sheekhoonatef15/OpenMCS/OpenMCS_V1/OpenMCS/Verification/500 ns_OpenMCS_100MHz_300MHz_test.csv

# OpenMCS 8.0.5-linear-fit-cps; clock_hz=100000000.000000; dwell_cycles=50; displayed_passes=5250235; roi_enabled=0\nTime (ns) | Count | Bin | In signal ROI | In noise ROI | Reference count
0.000000 | 0 | 0 | 0 | 0
500.000000 | 0 | 1 | 0 | 0
1000.000000 | 5250235 | 2 | 0 | 0
1500.000000 | 0 | 3 | 0 | 0
2000.000000 | 0 | 4 | 0 | 0
2500.000000 | 0 | 5 | 0 | 0
3000.000000 | 0 | 6 | 0 | 0
3500.000000 | 0 | 7 | 0 | 0
4000.000000 | 0 | 8 | 0 | 0
4500.000000 | 0 | 9 | 0 | 0
5000.000000 | 0 | 10 | 0 | 0
5500.000000 | 0 | 11 | 0 | 0
6000.000000 | 0 | 12 | 0 | 0
6500.000000 | 0 | 13 | 0 | 0
7000.000000 | 0 | 14 | 0 | 0
7500.000000 | 0 | 15 | 0 | 0
8000.000000 | 0 | 16 | 0 | 0
8500.000000 | 0 | 17 | 0 | 0
9000.000000 | 0 | 18 | 0 | 0
9500.000000 | 0 | 19 | 0 | 0
10000.000000 | 0 | 20 | 0 | 0
10500.000000 | 0 | 21 | 0 | 0
11000.000000 | 0 | 22 | 0 | 0
11500.000000 | 0 | 23 | 0 | 0
12000.000000 | 0 | 24 | 0 | 0
12500.000000 | 0 | 25 | 0 | 0
13000.000000 | 0 | 26 | 0 | 0
13500.000000 | 0 | 27 | 0 | 0
14000.000000 | 0 | 28 | 0 | 0
14500.000000 | 0 | 29 | 0 | 0
15000.000000 | 0 | 30 | 0 | 0
15500.000000 | 0 | 31 | 0 | 0
16000.000000 | 0 | 32 | 0 | 0
16500.000000 | 0 | 33 | 0 | 0
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
