sheekhoonatef15/OpenMCS/OpenMCS_V1/OpenMCS/Verification/500 ns_OpenMCS_100MHz_300MHz_test.png

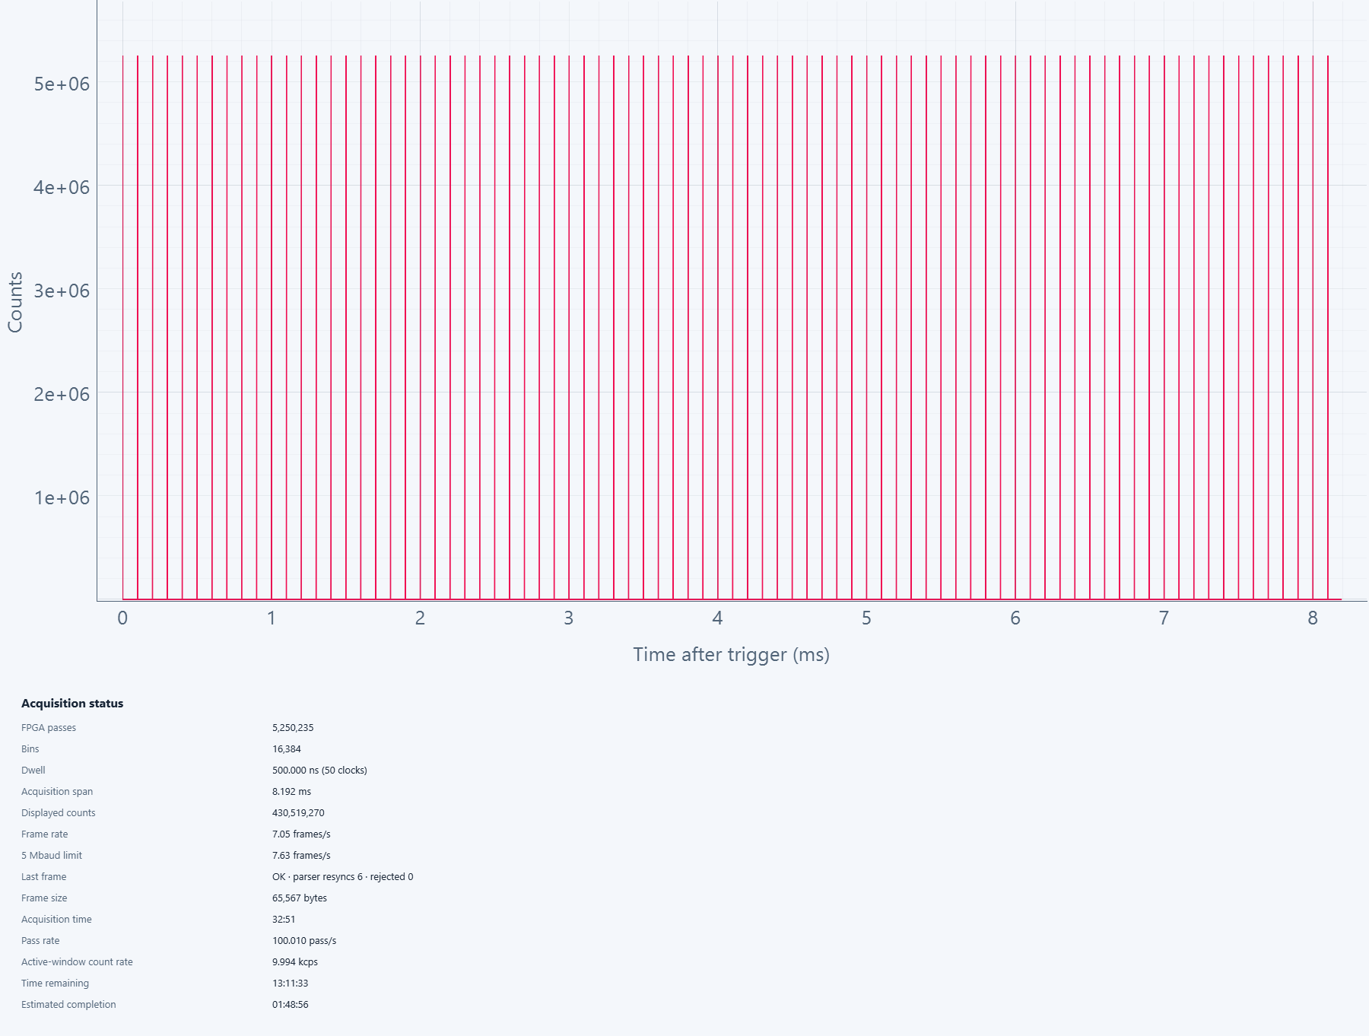
OpenMCS_V1/OpenMCS/Verification/500 ns_OpenMCS_100MHz_300MHz_test.png
