sheekhoonatef15/OpenMCS/OpenMCS_V1/OpenMCS/Software/OpenMCS_GUI.py

"""OpenMCS production GUI.

Receives FPGA-accumulated MCS6 histogram frames from the Teensy USB bridge and
performs interactive signal/background analysis.
"""

from __future__ import annotations

import math
import json
from pathlib import Path
import os
import queue
import re
import csv
from collections import deque
import struct
import sys
import threading
import time
from dataclasses import dataclass

import numpy as np
from OpenMCS_protocol import (
    FrameParser, MCS_MAGIC, LIVE_BLOCK_MAGIC, MCS_TRAILER,
    MAX_BINS, MIN_DWELL_CYCLES, EXPECTED_CLOCK_HZ,
)
import serial
import serial.tools.list_ports

os.environ["PYQTGRAPH_QT_LIB"] = "PyQt6"
import pyqtgraph as pg
import pyqtgraph.exporters

from PyQt6.QtCore import QEvent, QSettings, QSignalBlocker, QThread, QTimer, Qt, QRect, QRectF, pyqtSignal
from PyQt6.QtGui import QColor, QFont, QImage, QKeySequence, QPainter, QPen, QShortcut
from PyQt6.QtWidgets import (
    QApplication, QButtonGroup, QCheckBox, QColorDialog, QComboBox, QDoubleSpinBox,
    QFileDialog, QFormLayout, QDialog,
    QFrame, QGridLayout, QGroupBox, QHBoxLayout, QLabel, QLineEdit, QListWidget, QListWidgetItem, QMainWindow, QMessageBox,
    QPushButton, QScrollArea, QSpinBox, QSplitter, QStatusBar, QTabWidget, QTableWidget, QTableWidgetItem, QHeaderView,
    QVBoxLayout, QWidget,
)

APP_NAME = "OpenMCS"
APP_VERSION = "8.0.6-performance"
USB_BAUD = 115_200
# All released V3/V4 sketches in this project use the same line protocol.
# Match the stable family prefix so the maximum-accuracy V4 sketch connects.
TEENSY_ID = b"OPENMCS_TEENSY4_V"
STATUS_MAGIC = b"@@OPENMCS:"
DEFAULT_BINS = 10_000
MAX_MCS_DWELL_S = 0.001       # 1 ms/bin
MAX_MCS_PASS_SPAN_S = 20.0    # supports 16,384 bins at 1 ms/bin
BG = "#0b1016"
PANEL = "#121922"
PANEL_2 = "#17212c"
BORDER = "#293747"
TEXT = "#e7edf5"
MUTED = "#94a3b8"
CYAN = "#36c5f0"
GREEN = "#3ddc97"
AMBER = "#ffb454"
RED = "#ff6b6b"
LIGHT_BG = "#f4f7fb"


@dataclass(frozen=True)
class RegionMetrics:
    signal_start: int
    signal_end: int
    noise_start: int
    noise_end: int
    signal_bins: int
    noise_bins: int
    gross_signal: int
    noise_total: int
    noise_per_bin: float
    estimated_background: float
    net_signal: float
    uncertainty: float
    snr: float


def calculate_region_metrics(counts, signal_start, signal_end, noise_start, noise_end):
    """Background-scaled signal statistics for inclusive bin regions."""
    if counts.size == 0:
        raise ValueError("Histogram is empty")
    last = counts.size - 1
    signal_start = max(0, min(int(signal_start), last))
    signal_end = max(signal_start, min(int(signal_end), last))
    noise_start = max(0, min(int(noise_start), last))
    noise_end = max(noise_start, min(int(noise_end), last))
    signal_bins = signal_end - signal_start + 1
    noise_bins = noise_end - noise_start + 1
    gross = int(counts[signal_start : signal_end + 1].sum(dtype=np.uint64))
    noise_total = int(counts[noise_start : noise_end + 1].sum(dtype=np.uint64))
    noise_per_bin = noise_total / noise_bins
    scale = signal_bins / noise_bins
    background = scale * noise_total
    net = gross - background
    uncertainty = math.sqrt(max(0.0, gross + scale * scale * noise_total))
    snr = net / uncertainty if uncertainty else 0.0
    return RegionMetrics(
        signal_start, signal_end, noise_start, noise_end, signal_bins, noise_bins,
        gross, noise_total, noise_per_bin, background, net, uncertainty, snr,
    )


def linear_fit_active_rate(samples, pass_active_s):
    """Fit cumulative counts C(P)=m*P+b and return m/active-pass time."""
    if len(samples) < 2 or pass_active_s <= 0.0 or not math.isfinite(pass_active_s):
        return None
    passes = np.asarray([sample[0] for sample in samples], dtype=np.float64)
    totals = np.asarray([sample[1] for sample in samples], dtype=np.float64)
    passes -= passes.mean()
    totals -= totals.mean()
    denominator = float(np.dot(passes, passes))
    if denominator <= 0.0 or not math.isfinite(denominator):
        return None
    counts_per_pass = float(np.dot(passes, totals) / denominator)
    if counts_per_pass < 0.0 or not math.isfinite(counts_per_pass):
        return None
    return counts_per_pass / pass_active_s


def histogram_step_xy(x_values, counts):
    """Return staircase coordinates when x_values are LEFT EDGES of MCS bins.

    OpenMCS bin i spans [x[i], x[i] + dx].  For example, with a
    100 ns dwell: bin 0 = 0..100 ns, bin 1 = 100..200 ns, etc.
    """
    x = np.asarray(x_values, dtype=np.float64)
    y = np.asarray(counts)
    n = min(x.size, y.size)
    if n == 0:
        return np.asarray([], dtype=np.float64), np.asarray([], dtype=np.float64)
    x = x[:n]
    y = y[:n]

    if n == 1:
        # Safe fallback. Normal MCS displays contain multiple bins.
        dx = 1.0
    else:
        dx = float(x[-1] - x[-2])
        if not math.isfinite(dx) or dx <= 0.0:
            dx = 1.0

    # x[i] is the LEFT edge, not the center.  Append the right edge of
    # the final bin, then construct the explicit histogram staircase.
    edges = np.empty(n + 1, dtype=np.float64)
    edges[:-1] = x
    edges[-1] = x[-1] + dx
    sx = np.repeat(edges, 2)[1:-1]
    sy = np.repeat(y.astype(np.float64, copy=False), 2)
    return sx, sy




def available_ports():
    """Return serial ports with likely Teensy devices first."""
    ports = list(serial.tools.list_ports.comports())

    def is_teensy(port):
        text = " ".join(
            str(value or "")
            for value in (port.description, port.manufacturer, port.product, port.hwid)
        ).lower()
        return port.vid == 0x16C0 or "teensy" in text or "pjrc" in text

    ports.sort(key=lambda port: (not is_teensy(port), port.device))
    return ports


class SerialWorker(QThread):
    frame_received = pyqtSignal(object, object)
    connection_changed = pyqtSignal(bool, str)
    message = pyqtSignal(str, str)

    def __init__(self, port_name):
        super().__init__()
        self.port_name = port_name
        self._stop_event = threading.Event()
        self._commands = queue.Queue()
        self._status_buffer = bytearray()

    def _parse_instrument_status(self, data):
        """Display tagged Teensy messages without confusing them with MCS6 data."""
        self._status_buffer.extend(data)
        while True:
            marker = self._status_buffer.find(STATUS_MAGIC)
            if marker < 0:
                preserve = len(STATUS_MAGIC) - 1
                if len(self._status_buffer) > preserve:
                    del self._status_buffer[:-preserve]
                return
            newline = self._status_buffer.find(b"\n", marker)
            if newline < 0:
                if marker:
                    del self._status_buffer[:marker]
                return
            record = bytes(self._status_buffer[marker + len(STATUS_MAGIC):newline])
            del self._status_buffer[:newline + 1]
            try:
                level_bytes, message_bytes = record.split(b":", 1)
                level = level_bytes.decode("ascii", errors="replace").lower()
                message = message_bytes.decode("utf-8", errors="replace").strip()
            except ValueError:
                continue
            if level == "identity":
                continue
            if level not in ("info", "success", "warning", "error"):
                level = "info"
            if message:
                self.message.emit(message, level)

    @staticmethod
    def _verify_teensy(serial_port):
        """Reject a COM port unless the current OpenMCS Teensy sketch answers."""
        serial_port.reset_input_buffer()
        serial_port.write(b"i\n")
        serial_port.flush()
        reply = bytearray()
        deadline = time.monotonic() + 4.0
        while time.monotonic() < deadline:
            waiting = serial_port.in_waiting
            chunk = serial_port.read(waiting if waiting else 1)
            if chunk:
                reply.extend(chunk)
                if TEENSY_ID in reply:
                    return bytes(reply)
                if len(reply) > 8192:
                    del reply[:-4096]
        raise RuntimeError(
            "The selected COM port did not identify as the OpenMCS Teensy. "
            "Select the Teensy COM port and upload the matching OpenMCS_Teensy4_0.ino sketch."
        )

    def send_command(self, command):
        self._commands.put(command.strip() + "\n")

    def stop(self):
        self._stop_event.set()

    def run(self):
        serial_port = None
        parser = FrameParser()
        try:
            serial_port = serial.Serial(
                self.port_name, USB_BAUD, timeout=0.05, write_timeout=1.0
            )
            startup_reply = self._verify_teensy(serial_port)
            self._parse_instrument_status(startup_reply)
            self.connection_changed.emit(True, self.port_name)
            while not self._stop_event.is_set():
                while True:
                    try:
                        command = self._commands.get_nowait()
                    except queue.Empty:
                        break
                    serial_port.write(command.encode("ascii"))
                    serial_port.flush()
                waiting = serial_port.in_waiting
                data = serial_port.read(waiting if waiting else 1)
                if data:
                    self._parse_instrument_status(data)
                    for counts, metadata in parser.feed(data):
                        metadata["discarded_bytes"] = parser.discarded_bytes
                        metadata["invalid_frames"] = parser.invalid_frames
                        self.frame_received.emit(counts, metadata)
        except (serial.SerialException, OSError, RuntimeError) as error:
            self.message.emit(f"Serial connection error: {error}", "error")
        finally:
            if serial_port is not None:
                try:
                    serial_port.close()
                except serial.SerialException:
                    pass
            self.connection_changed.emit(False, self.port_name)


class MetricValue(QFrame):
    def __init__(self, title, value="—"):
        super().__init__()
        self.setObjectName("MetricValue")
        layout = QVBoxLayout(self)
        layout.setContentsMargins(10, 8, 10, 8)
        layout.setSpacing(1)
        caption = QLabel(title)
        caption.setObjectName("MetricCaption")
        self.value = QLabel(value)
        self.value.setObjectName("MetricNumber")
        self.value.setTextInteractionFlags(Qt.TextInteractionFlag.TextSelectableByMouse)
        layout.addWidget(caption)
        layout.addWidget(self.value)

    def set_value(self, value):
        self.value.setText(value)


class SelectionViewBox(pg.ViewBox):
    """ViewBox that reserves Ctrl + left-drag for histogram selection."""

    selectionDragged = pyqtSignal(float, float, bool)

    def mouseDragEvent(self, event, axis=None):
        ctrl_left_drag = (
            event.button() == Qt.MouseButton.LeftButton and
            bool(event.modifiers() & Qt.KeyboardModifier.ControlModifier)
        )
        if not ctrl_left_drag:
            super().mouseDragEvent(event, axis=axis)
            return
        event.accept()
        start = self.mapSceneToView(event.buttonDownScenePos()).x()
        current = self.mapSceneToView(event.scenePos()).x()
        self.selectionDragged.emit(
            float(min(start, current)), float(max(start, current)),
            bool(event.isFinish()),
        )


class SelectAllLineEdit(QLineEdit):
    """Select all text whenever the field is clicked."""
    def mousePressEvent(self, event):
        super().mousePressEvent(event)
        QTimer.singleShot(0, self.selectAll)


class InsetResizeHandle(QWidget):
    """Bottom-right handle that resizes only its FloatingOverview parent."""

    def __init__(self, inset):
        super().__init__(inset)
        self.inset = inset
        self._press_global = None
        self._start_size = None
        self._background = QColor("#526579")
        self._border = QColor("#94a3b8")
        self.setFixedSize(24, 24)
        self.setCursor(Qt.CursorShape.SizeFDiagCursor)
        self.setToolTip("Drag to resize overview only")
        self.setAttribute(Qt.WidgetAttribute.WA_OpaquePaintEvent, True)

    def setThemeColors(self, background, border):
        self._background = QColor(background)
        self._border = QColor(border)
        self.update()

    def paintEvent(self, event):
        painter = QPainter(self)
        painter.fillRect(self.rect(), self._background)
        painter.setPen(QPen(self._border, 2.0))
        # Three diagonal grip marks make the resize target visually obvious.
        w = self.width() - 5
        h = self.height() - 5
        for offset in (0, 6, 12):
            painter.drawLine(w - offset, h, w, h - offset)

    def mousePressEvent(self, event):
        if event.button() == Qt.MouseButton.LeftButton:
            self._press_global = event.globalPosition().toPoint()
            self._start_size = self.inset.size()
            self.grabMouse()
            event.accept()
            return
        event.ignore()

    def mouseMoveEvent(self, event):
        if self._press_global is None or self._start_size is None:
            event.ignore()
            return
        delta = event.globalPosition().toPoint() - self._press_global
        new_w = max(self.inset.minimumWidth(), self._start_size.width() + delta.x())
        new_h = max(self.inset.minimumHeight(), self._start_size.height() + delta.y())
        # Critical: resize ONLY the floating inset. No splitter, parent, or main plot changes.
        self.inset.resize(new_w, new_h)
        self.inset.raise_()
        event.accept()

    def mouseReleaseEvent(self, event):
        if self._press_global is not None:
            self._press_global = None
            self._start_size = None
            self.releaseMouse()
            event.accept()
            return
        event.ignore()


class FloatingOverview(QFrame):
    """Layout-independent overview overlay. Drag title; resize with bottom-right grip."""
    navigateRequested = pyqtSignal(float)

    def __init__(self, parent=None):
        super().__init__(parent)
        self.setObjectName("FloatingOverview")
        self.setMinimumSize(180, 120)
        self.resize(320, 190)
        self._drag_origin = None
        self._frame_origin = None

        layout = QVBoxLayout(self)
        layout.setContentsMargins(2, 2, 2, 2)
        layout.setSpacing(0)

        self.title = QLabel("Spectrum overview — drag to move")
        self.title.setFixedHeight(24)
        self.title.setCursor(Qt.CursorShape.SizeAllCursor)
        self.title.installEventFilter(self)
        layout.addWidget(self.title)

        self.plot = pg.PlotWidget()
        self.plot.setMenuEnabled(False)
        self.plot.hideAxis("left")
        self.plot.hideAxis("bottom")
        self.plot.setMouseEnabled(x=False, y=False)
        self.plot.scene().sigMouseClicked.connect(self._clicked)
        layout.addWidget(self.plot, 1)

        # Custom handle: QSizeGrip would target a top-level/subwindow and can
        # resize the OpenMCS window. This handle explicitly resizes only self.
        self.grip = InsetResizeHandle(self)
        self.grip.setThemeColors("#526579", "#cbd5e1")
        self.grip.raise_()

    def resizeEvent(self, event):
        super().resizeEvent(event)
        self.grip.move(self.width() - self.grip.width() - 2,
                       self.height() - self.grip.height() - 2)
        self.grip.raise_()

    def eventFilter(self, obj, event):
        if obj is self.title:
            if event.type() == QEvent.Type.MouseButtonPress and event.button() == Qt.MouseButton.LeftButton:
                self._drag_origin = event.globalPosition().toPoint()
                self._frame_origin = self.pos()
                return True
            if event.type() == QEvent.Type.MouseMove and self._drag_origin is not None:
                delta = event.globalPosition().toPoint() - self._drag_origin
                self.move(self._frame_origin + delta)
                self.raise_()
                return True
            if event.type() == QEvent.Type.MouseButtonRelease:
                self._drag_origin = None
                self._frame_origin = None
                return True
        return super().eventFilter(obj, event)

    def _clicked(self, event):
        if event.button() == Qt.MouseButton.LeftButton:
            point = self.plot.getViewBox().mapSceneToView(event.scenePos())
            self.navigateRequested.emit(float(point.x()))

    def addItem(self, item):
        self.plot.addItem(item)

    def setRange(self, *args, **kwargs):
        self.plot.setRange(*args, **kwargs)

    def setThemeColors(self, background, border):
        self.setStyleSheet(
            f"QFrame#FloatingOverview {{ background:{background}; border:2px solid {border}; }}"
            f"QLabel {{ background:{background}; padding-left:6px; font-weight:600; }}"
        )
        self.plot.setBackground(background)
        # Deliberately contrast the custom resize handle with the panel.
        grip_bg = "#526579" if QColor(background).lightness() < 128 else "#cbd5e1"
        grip_border = "#f8fafc" if QColor(background).lightness() < 128 else "#334155"
        self.grip.setThemeColors(grip_bg, grip_border)

class OpenMCSWindow(QMainWindow):
    def __init__(self):
        super().__init__()
        self.settings = QSettings("OpenMCS", "OpenMCS")
        self.worker = None
        self._live_preview_metadata = None
        self._live_preview_warning = False
        self.live_preview_timer = QTimer(self)
        self.live_preview_timer.setSingleShot(True)
        self.live_preview_timer.setInterval(33)
        self.live_preview_timer.timeout.connect(self._render_live_preview)
        self.latest_counts = None
        self.latest_metadata = None
        self.mcs_latest_counts = None
        self.mcs_latest_metadata = None
        self.mcs_accumulation_frames = 0
        self.counter_latest_counts = None
        self.counter_latest_metadata = None
        self.pass_number = 0
        self.accumulation_frames = 0
        self.accumulation_signature = None
        self.rejected_frames = 0
        self.frame_timestamps = deque(maxlen=512)
        self.frame_rate_ema = 0.0
        self._updating_regions = False
        self._auto_connect_attempted = False
        self.instrument_mode = "mcs"
        self.trace_color = CYAN
        self.counter_signal_color = CYAN
        self.counter_trigger_color = AMBER
        self.x_axis_mode = "time"
        self.counter_times = []
        self.counter_cps = []
        self.counter_trigger_cps = []
        self.counter_last_count = 0
        self.counter_last_trigger_count = 0
        self.counter_last_pass = 0
        self.counter_segment_count = 0
        self.counter_segment_signal_sum = 0
        self.counter_segment_trigger_sum = 0
        self.counter_segment_elapsed = 0.0
        self.counter_started = None
        self.counter_baseline_pending = True
        self.counter_segments_per_point = 1
        self.counter_accept_after = 0.0
        self.mode_accept_after = 0.0
        self.acquisition_running = False
        self.mcs_display_frozen = False
        self.mcs_view_initialized = False
        # User-requested live auto-range. Off by default so acquisition does not move the view.
        self.mcs_manual_autorange = False
        self.mcs_clear_pending = False
        self.configured_signature = None
        self.highlighted_bins = None
        # Frozen comparison/reference histogram. This is GUI-only and survives
        # new acquisitions until explicitly replaced or removed.
        self.reference_counts = None
        self.reference_metadata = None
        self.reference_curve = None
        self.reference_axis_mode = None
        self.acquisition_started_at = None
        self.acquisition_stopped_at = None
        self.acquisition_baseline_passes = 0
        self.acquisition_target_passes = None
        # MCS live-rate history. Rates are calculated from successive cumulative
        # FPGA frames, never from GUI paint/update frequency.
        self.mcs_rate_times = []  # retain full CPS history for troubleshooting
        self.mcs_count_rates = []
        self.mcs_pass_rates = []
        self.mcs_rate_last_time = None
        self.mcs_rate_last_total = None
        self.mcs_rate_last_passes = None
        self.mcs_rate_started = None
        self.mcs_rate_fit_samples = deque(maxlen=8)
        self.mcs_rate_fit_signature = None
        # First live MCS frame after every Start is baseline-only for CPS.
        self.mcs_rate_baseline_pending = True
        self.eta_pass_samples = deque()
        self.eta_window_seconds = 10.0
        self.eta_min_span_seconds = 1.0
        self.eta_last_rate = None
        self.eta_interval_values = []
        self.eta_interval_rates = []
        self.eta_display_eta = None
        self.eta_display_rate = None
        self.eta_last_display_update = time.monotonic()
        self.eta_display_period_s = 5.0
        self._counter_start_pending = False
        # Independent plot view ranges are preserved when switching modes.
        self._mcs_saved_view = None
        self._counter_saved_view = None
        # User-measured acquisition clock. The FPGA protocol continues to
        # identify the nominal 100 MHz design; this value corrects all physical
        # time and rate calculations in both MCS and Counter displays.
        self.clock_frequency_hz = self.settings.value(
            "calibration/clock_hz", float(EXPECTED_CLOCK_HZ), float
        )
        self._layout_editor = None
        self._layout_selected_widget = None
        self._layout_selected_style = ""
        self._layout_edit_active = False

        self.setWindowTitle(f"{APP_NAME} {APP_VERSION} — Multichannel Scaler")
        self.resize(1280, 780)
        self.setMinimumSize(980, 640)
        self._build_ui()
        self._connect_signals()
        self._install_shortcuts()
        self._restore_settings()
        self._set_connected(False)
        self.refresh_ports()
        self.port_timer = QTimer(self)
        self.port_timer.timeout.connect(self.refresh_ports)
        self.port_timer.start(2000)
        self.acquisition_timer = QTimer(self)
        self.acquisition_timer.timeout.connect(self._update_acquisition_timing)
        self.acquisition_timer.start(250)
        QTimer.singleShot(350, self._try_initial_auto_connect)

    def _build_ui(self):
        scroll_area = QScrollArea()
        scroll_area.setObjectName("MainScrollArea")
        scroll_area.setWidgetResizable(True)
        scroll_area.setFrameShape(QFrame.Shape.NoFrame)
        root = QWidget()
        # Preserve a useful plot height on smaller displays. The main window
        # becomes vertically scrollable instead of compressing labels, toolbars,
        # and plots until text disappears.
        root.setMinimumSize(900, 820)
        scroll_area.setWidget(root)
        self.main_scroll_area = scroll_area
        self.setCentralWidget(scroll_area)
        outer = QVBoxLayout(root)
        outer.setContentsMargins(14, 12, 14, 10)
        outer.setSpacing(10)

        header = QHBoxLayout()
        self.header_layout = header
        title_box = QVBoxLayout()
        self.app_title_label = QLabel("OpenMCS")
        self.app_title_label.setObjectName("CompactTitle" if os.environ.get("OPENQMA_EMBEDDED") else "AppTitle")
        self.app_subtitle_label = QLabel(
            "Triggered multichannel scaler · 100 MHz FPGA accumulation · "
            "GUI v6.7"
        )
        self.app_subtitle_label.setObjectName("AppSubtitle")
        self.app_subtitle_label.setWordWrap(True)
        self.app_subtitle_label.setMinimumWidth(0)
        if os.environ.get("OPENQMA_EMBEDDED"):
            self.app_subtitle_label.setVisible(False)
        title_box.addWidget(self.app_title_label)
        title_box.addWidget(self.app_subtitle_label)
        header.addLayout(title_box)
        header.addStretch(1)

        # Always-visible mode selector. Switching instruments should not
        # require opening Setup or finding a combo box among acquisition fields.
        mode_switch = QFrame()
        mode_switch.setObjectName("ModeSwitch")
        mode_layout = QHBoxLayout(mode_switch)
        mode_layout.setContentsMargins(4, 4, 4, 4)
        mode_layout.setSpacing(3)
        mode_label = QLabel("MODE")
        mode_label.setObjectName("ModeLabel")
        self.mcs_mode_button = QPushButton("MCS")
        self.counter_mode_button = QPushButton("COUNTER")
        for button in (self.mcs_mode_button, self.counter_mode_button):
            button.setObjectName("ModeButton")
            button.setCheckable(True)
            button.setMinimumWidth(86)
        self.mcs_mode_button.setToolTip("Triggered multichannel scaler (Ctrl+1)")
        self.counter_mode_button.setToolTip("Continuous CPS alignment counter (Ctrl+2)")
        self.mode_button_group = QButtonGroup(self)
        self.mode_button_group.setExclusive(True)
        self.mode_button_group.addButton(self.mcs_mode_button)
        self.mode_button_group.addButton(self.counter_mode_button)
        self.mcs_mode_button.setChecked(True)
        mode_layout.addWidget(mode_label)
        mode_layout.addWidget(self.mcs_mode_button)
        mode_layout.addWidget(self.counter_mode_button)
        header.addWidget(mode_switch)

        self.setup_button = QPushButton("Setup")
        self.setup_button.setToolTip("Show acquisition setup (Ctrl+, or F2)")
        self.shortcuts_button = QPushButton("Shortcuts")
        self.shortcuts_button.setCheckable(True)
        self.shortcuts_button.setToolTip("Show/hide keyboard shortcuts")
        self.theme_combo = QComboBox()
        self.theme_combo.addItem("Dark", "dark")
        self.theme_combo.addItem("Light", "light")
        self.theme_combo.setToolTip("Interface color theme")
        self.help_button = QPushButton("Help")
        self.help_button.setToolTip("Open help and keyboard shortcuts (F1)")
        self.layout_button = QPushButton("Edit layout")
        self.layout_button.setToolTip("Show, hide, and resize the workspace panels")
        self.header_actions = QWidget()
        self.header_actions_layout = QHBoxLayout(self.header_actions)
        self.header_actions_layout.setContentsMargins(0, 0, 0, 0)
        self.header_actions_layout.setSpacing(8)
        self.header_actions_layout.addWidget(self.setup_button)
        self.header_actions_layout.addWidget(self.layout_button)
        self.header_actions_layout.addWidget(self.shortcuts_button)
        self.header_actions_layout.addWidget(self.theme_combo)
        self.header_actions_layout.addWidget(self.help_button)
        header.addWidget(self.header_actions)
        self.connection_badge = QLabel("●  DISCONNECTED")
        self.connection_badge.setObjectName("ConnectionBadge")
        header.addWidget(self.connection_badge)
        outer.addLayout(header)

        # The right Status/ROI pane spans the full working height.  Everything
        # that supports acquisition lives in a compact left stack so the plot
        # receives essentially all remaining space.
        self.workspace_splitter = QSplitter(Qt.Orientation.Horizontal)
        self.workspace_splitter.setChildrenCollapsible(False)
        self.workspace_splitter.setHandleWidth(3)
        outer.addWidget(self.workspace_splitter, 1)

        left_workspace = QWidget()
        left_workspace_layout = QVBoxLayout(left_workspace)
        left_workspace_layout.setContentsMargins(0, 0, 0, 0)
        left_workspace_layout.setSpacing(8)
        self.workspace_splitter.addWidget(left_workspace)

        connection = QFrame()
        self.connection_bar = connection
        connection.setObjectName("ControlBar")
        connection_layout = QHBoxLayout(connection)
        self.connection_layout = connection_layout
        connection_layout.setContentsMargins(10, 5, 10, 5)
        self.instrument_label = QLabel("Instrument")
        connection_layout.addWidget(self.instrument_label)
        self.port_combo = QComboBox()
        self.port_combo.setMinimumWidth(220)
        self.refresh_button = QPushButton("Refresh")
        self.connect_button = QPushButton("Connect")
        self.connect_button.setObjectName("PrimaryButton")
        self.auto_connect_check = QCheckBox("Auto-connect")
        self.auto_connect_check.setChecked(True)
        connection_layout.addWidget(self.port_combo, 1)
        connection_layout.addWidget(self.refresh_button)
        connection_layout.addWidget(self.auto_connect_check)
        connection_layout.addWidget(self.connect_button)
        left_workspace_layout.addWidget(connection)

        # Persistent experiment save target. This removes repeated Save dialogs
        # during acquisition: choose a folder and run name once, then use Save Data.
        save_bar = QFrame()
        self.save_bar = save_bar
        save_bar.setObjectName("ControlBar")
        save_layout = QHBoxLayout(save_bar)
        self.save_layout = save_layout
        save_layout.setContentsMargins(10, 5, 10, 5)
        save_layout.setSpacing(6)

        self.save_to_label = QLabel("Save to")
        save_layout.addWidget(self.save_to_label)
        self.save_directory_edit = QLineEdit()
        self.save_directory_edit.setPlaceholderText("Experiment folder")
        self.save_directory_edit.setToolTip("Folder used by Save Data")
        self.save_directory_edit.setMinimumWidth(220)

        self.browse_save_directory_button = QPushButton("Browse…")
        self.browse_save_directory_button.setToolTip("Choose experiment folder")

        save_layout.addWidget(self.save_directory_edit, 2)
        save_layout.addWidget(self.browse_save_directory_button)

        self.run_name_label = QLabel("Run name")
        save_layout.addWidget(self.run_name_label)
        self.run_name_edit = SelectAllLineEdit()
        self.run_name_edit.setPlaceholderText("sample_001")
        self.run_name_edit.setToolTip(
            "Base filename. Save Data always creates CSV and optionally creates PNG. "
            "The entered name is preserved; an existing name receives a numbered suffix."
        )
        self.run_name_edit.setMinimumWidth(150)
        save_layout.addWidget(self.run_name_edit, 1)

        self.data_settings_button = QPushButton("Data Settings…")
        self.data_settings_button.setToolTip(
            "Choose saved columns, column names/order, and visible acquisition-status fields"
        )
        save_layout.addWidget(self.data_settings_button)

        self.save_image_check = QCheckBox("Save image")
        self.save_image_check.setChecked(True)
        self.save_image_check.setToolTip("Save a PNG together with the CSV")
        save_layout.addWidget(self.save_image_check)
        self.save_data_button = QPushButton("Save Data")
        self.save_data_button.setObjectName("PrimaryButton")
        self.save_data_button.setToolTip(
            "Save CSV and, when selected, a spectrum image using the folder and run name"
        )
        save_layout.addWidget(self.save_data_button)
        left_workspace_layout.addWidget(save_bar)

        # Acquisition setup lives in the right-side column.  A vertical layout
        # prevents labels/buttons from colliding when the window is resized.
        acquisition = QGroupBox("Acquisition controls")
        self.acquisition_group = acquisition
        setup = QVBoxLayout(acquisition)
        setup.setContentsMargins(10, 8, 10, 8)
        setup.setSpacing(7)

        self.bins_spin = QSpinBox()
        self.bins_spin.setRange(1, MAX_BINS)
        self.bins_spin.setGroupSeparatorShown(True)
        self.bins_spin.setValue(DEFAULT_BINS)

        self.dwell_spin = QDoubleSpinBox()
        self.dwell_spin.setRange(0.001, 10_000_000.0)
        self.dwell_spin.setDecimals(3)
        self.dwell_spin.setValue(100.0)
        self.dwell_unit = QComboBox()
        for label, multiplier in (("ns", 1e-9), ("µs", 1e-6), ("ms", 1e-3), ("s", 1.0)):
            self.dwell_unit.addItem(label, multiplier)

        self.trigger_spin = QSpinBox()
        self.trigger_spin.setRange(1, 1_000_000)
        self.trigger_spin.setGroupSeparatorShown(True)
        self.trigger_spin.setSuffix(" Hz")
        self.trigger_spin.setValue(100)
        self.trigger_edge_combo = QComboBox()
        self.trigger_edge_combo.addItem("Rising edge", "r")
        self.trigger_edge_combo.addItem("Falling edge", "f")
        self.trigger_edge_combo.setToolTip(
            "Select which H2 edge the FPGA uses as MCS time zero. "
            "This does not change the Teensy H2/H4 waveforms."
        )

        # Normal MCS deterministic max-pass control. The FPGA enforces this in
        # the acquisition clock domain; physical trigger/event sources continue.
        self.max_passes_label = QLabel("Max passes")
        self.max_passes_spin = QSpinBox()
        self.max_passes_spin.setRange(1, 1_000_000_000)
        self.max_passes_spin.setGroupSeparatorShown(True)
        self.max_passes_spin.setValue(5_000)
        self.max_passes_spin.setToolTip(
            "Maximum passes accepted by the FPGA after each Start"
        )
        self.unlimited_passes_check = QCheckBox("Continuous mode (no pass limit)")
        self.unlimited_passes_check.setChecked(False)
        self.unlimited_passes_check.setToolTip(
            "Disable the max-pass limit. Teensy command m 0 selects continuous acquisition."
        )

        self.test_passes_label = QLabel("Passes")
        self.test_passes_spin = QSpinBox()
        self.test_passes_spin.setRange(1, 1_000_000_000)
        self.test_passes_spin.setGroupSeparatorShown(True)
        self.test_passes_spin.setValue(2_000)
        self.test_passes_spin.setToolTip(
            "FPGA passes accepted per Start; the self-test waveform continues afterward"
        )

        self.self_test_check = QCheckBox("Test mode / Self test")
        self.self_test_check.setToolTip(
            "Continuously generate the Teensy hardware self-test signals. This state persists across MCS/Counter mode changes."
        )
        self.counter_self_test_check = QCheckBox("Test mode / Self test")
        self.counter_self_test_check.setToolTip(
            "Same persistent Teensy self-test switch as MCS. Turning either switch on/off updates the other."
        )
        self.internal_signal_check = QCheckBox("Internal signal")
        self.internal_signal_check.setToolTip(
            "Continuously generate the signal on Teensy pin 9"
        )

        self.counter_dwell_label = QLabel("Counter dwell")
        self.counter_dwell_spin = QDoubleSpinBox()
        self.counter_dwell_spin.setRange(0.001, 50.0)
        self.counter_dwell_spin.setDecimals(3)
        self.counter_dwell_spin.setSingleStep(0.1)
        self.counter_dwell_spin.setSuffix(" s")
        self.counter_dwell_spin.setValue(0.100)
        self.counter_dwell_spin.setToolTip(
            "Displayed Counter dwell, up to 50 seconds. Long dwells are "
            "automatically combined from safe 32-bit FPGA dwell segments."
        )
        self.counter_hint = QLabel(
            "Both inputs are counted simultaneously during the same dwell:\n"
            "Signal input = FPGA H4  |  Trigger input = FPGA H2"
        )
        self.counter_hint.setObjectName("HintLabel")
        self.counter_hint.setWordWrap(True)

        self.quantized_label = QLabel()
        self.quantized_label.setObjectName("HintLabel")
        self.quantized_label.setWordWrap(True)

        self.configure_button = QPushButton("Apply configuration")
        self.configure_button.setObjectName("PrimaryButton")
        self.run_button = QPushButton("Run internal")
        self.run_button.setObjectName("RunButton")
        self.external_button = QPushButton("Run external")
        self.stop_button = QPushButton("Stop")
        self.single_button = QPushButton("Single trigger")
        self.reset_button = QPushButton("Clear accumulation")

        self.bins_label = QLabel("Bins")
        self.dwell_label = QLabel("Dwell")
        self.trigger_label = QLabel("Trigger")
        self.mode_description = QLabel("Triggered MCS")
        self.mode_description.setObjectName("HintLabel")
        self.mode_description.setWordWrap(True)

        setup_form = QFormLayout()
        setup_form.setFieldGrowthPolicy(QFormLayout.FieldGrowthPolicy.AllNonFixedFieldsGrow)
        setup_form.setRowWrapPolicy(QFormLayout.RowWrapPolicy.WrapLongRows)
        setup_form.setHorizontalSpacing(10)
        setup_form.setVerticalSpacing(6)
        setup_form.addRow(self.bins_label, self.bins_spin)

        dwell_row = QWidget()
        dwell_box = QHBoxLayout(dwell_row)
        dwell_box.setContentsMargins(0, 0, 0, 0)
        dwell_box.setSpacing(5)
        dwell_box.addWidget(self.dwell_spin, 1)
        dwell_box.addWidget(self.dwell_unit)
        setup_form.addRow(self.dwell_label, dwell_row)
        setup_form.addRow(self.trigger_label, self.trigger_spin)
        setup_form.addRow("Trigger edge", self.trigger_edge_combo)
        setup_form.addRow(self.max_passes_label, self.max_passes_spin)
        setup_form.addRow("", self.unlimited_passes_check)
        setup_form.addRow(self.test_passes_label, self.test_passes_spin)
        setup_form.addRow(self.counter_dwell_label, self.counter_dwell_spin)
        setup.addLayout(setup_form)

        setup.addWidget(self.internal_signal_check)
        setup.addWidget(self.self_test_check)
        setup.addWidget(self.counter_self_test_check)
        setup.addWidget(self.counter_hint)
        setup.addWidget(self.quantized_label)
        setup.addWidget(self.mode_description)
        setup.addWidget(self.configure_button)

        self.calibration_group = QGroupBox("Clock-frequency calibration")
        cal = QGridLayout(self.calibration_group)
        cal_help = QLabel(
            "Enter the measured FPGA acquisition-clock frequency. This value "
            "is applied to MCS time bins and both Counter CPS channels."
        )
        cal_help.setWordWrap(True)
        self.clock_frequency_spin = QDoubleSpinBox()
        self.clock_frequency_spin.setRange(1.0, 1000.0)
        self.clock_frequency_spin.setDecimals(6)
        self.clock_frequency_spin.setSuffix(" MHz")
        self.clock_frequency_spin.setValue(self.clock_frequency_hz / 1e6)
        self.clock_frequency_apply_button = QPushButton("Apply clock frequency")
        self.clock_frequency_reset_button = QPushButton("Reset to 100 MHz")
        cal.addWidget(cal_help, 0, 0, 1, 2)
        cal.addWidget(QLabel("Measured clock"), 1, 0)
        cal.addWidget(self.clock_frequency_spin, 1, 1)
        cal.addWidget(self.clock_frequency_apply_button, 2, 0)
        cal.addWidget(self.clock_frequency_reset_button, 2, 1)
        setup.addWidget(self.calibration_group)

        run_row = QGridLayout()
        run_row.setHorizontalSpacing(6)
        run_row.setVerticalSpacing(6)
        run_row.addWidget(self.run_button, 0, 0)
        run_row.addWidget(self.external_button, 0, 1)
        run_row.addWidget(self.single_button, 1, 0)
        run_row.addWidget(self.stop_button, 1, 1)
        run_row.addWidget(self.reset_button, 2, 0, 1, 2)
        setup.addLayout(run_row)
        acquisition.setVisible(False)

        plot_frame = QFrame()
        self.plot_frame = plot_frame
        plot_frame.setObjectName("PlotPanel")
        plot_layout = QVBoxLayout(plot_frame)
        plot_layout.setContentsMargins(8, 8, 8, 8)
        title_toolbar = QHBoxLayout()
        plot_toolbar = QHBoxLayout()
        self.title_toolbar = title_toolbar
        self.plot_toolbar = plot_toolbar
        self.quick_run_button = QPushButton("▶ Start")
        self.quick_run_button.setObjectName("RunButton")
        self.quick_run_button.setToolTip("Start acquisition (F5)")
        self.quick_stop_button = QPushButton("■ Stop")
        self.quick_stop_button.setToolTip("Stop acquisition (Shift+F5 or Esc)")
        self.quick_clear_button = QPushButton("Clear")
        self.quick_clear_button.setToolTip("Clear FPGA accumulation (Ctrl+L)")
        self.plot_title = QLabel("Histogram — waiting for data")
        self.plot_title.setObjectName("SectionTitle")
        self.auto_y_check = QPushButton("Fit Y")
        self.auto_y_check.setCheckable(True)
        self.auto_y_check.setChecked(False)
        self.auto_y_check.setToolTip("Toggle live Y fitting. When enabled, Y expands with accumulating data; click again to switch it off.")
        self.log_y_check = QCheckBox("Log Y")
        self.plot_rate_check = QCheckBox("Plot count rate")
        self.plot_rate_check.setChecked(True)
        self.clear_rate_button = QPushButton("Clear CPS")
        self.clear_rate_button.setToolTip("Clear only MCS CPS history; preserve histogram")
        self.counter_signal_check = QCheckBox("H4 Signal (L)")
        self.counter_signal_check.setChecked(True)
        self.counter_signal_check.setToolTip("Show/hide Signal CPS on the left Y axis")
        self.counter_signal_color_button = QPushButton("●")
        self.counter_signal_color_button.setFixedWidth(30)
        self.counter_signal_color_button.setToolTip("Choose H4 Signal trace color")
        self.counter_trigger_check = QCheckBox("H2 Trigger (R)")
        self.counter_trigger_check.setChecked(True)
        self.counter_trigger_check.setToolTip("Show/hide Trigger CPS on the right Y axis")
        self.counter_trigger_color_button = QPushButton("●")
        self.counter_trigger_color_button.setFixedWidth(30)
        self.counter_trigger_color_button.setToolTip("Choose H2 Trigger trace color")
        self.counter_signal_check.setVisible(False)
        self.counter_signal_color_button.setVisible(False)
        self.counter_trigger_check.setVisible(False)
        self.counter_trigger_color_button.setVisible(False)
        self.plot_rate_check.setToolTip(
            "Show/hide detector CPS derived from FPGA histogram increments and active acquisition time"
        )
        self.roi_enable_check = QPushButton("ROI: OFF")
        self.roi_enable_check.setObjectName("ROIButton")
        self.roi_enable_check.setCheckable(True)
        self.roi_enable_check.setChecked(False)
        self.roi_enable_check.setToolTip(
            "Show signal/noise regions and live ROI calculations"
        )
        self.reference_button = QPushButton("Freeze reference")
        self.reference_button.setToolTip(
            "Freeze the currently displayed MCS histogram as a transparent comparison overlay"
        )
        self.clear_reference_button = QPushButton("Remove reference")
        self.clear_reference_button.setToolTip(
            "Remove the frozen comparison histogram"
        )
        self.clear_reference_button.setEnabled(False)

        self.difference_button = QPushButton("Difference: OFF")
        self.difference_button.setObjectName("ROIButton")
        self.difference_button.setCheckable(True)
        self.difference_button.setChecked(False)
        self.difference_button.setToolTip(
            "Show the background-subtracted signal ROI beside the raw MCS"
        )
        self.save_csv_button = QPushButton("Export CSV")
        self.save_plot_button = QPushButton("Export image")
        self.trace_color_button = QPushButton("Trace color")
        self.trace_color_button.setToolTip("Choose the MCS/counter trace color")
        title_toolbar.addWidget(self.plot_title, 1)
        title_toolbar.addWidget(self.roi_enable_check)
        title_toolbar.addWidget(self.difference_button)
        title_toolbar.addWidget(self.reference_button)
        title_toolbar.addWidget(self.clear_reference_button)
        plot_toolbar.addWidget(self.quick_run_button)
        plot_toolbar.addWidget(self.quick_stop_button)
        plot_toolbar.addWidget(self.quick_clear_button)
        plot_toolbar.addStretch(1)
        plot_toolbar.addWidget(self.auto_y_check)
        plot_toolbar.addWidget(self.log_y_check)
        plot_toolbar.addWidget(self.counter_signal_check)
        plot_toolbar.addWidget(self.counter_signal_color_button)
        plot_toolbar.addWidget(self.counter_trigger_check)
        plot_toolbar.addWidget(self.counter_trigger_color_button)
        plot_toolbar.addWidget(self.plot_rate_check)
        plot_toolbar.addWidget(self.clear_rate_button)
        plot_toolbar.addWidget(self.trace_color_button)
        plot_toolbar.addWidget(self.save_csv_button)
        plot_toolbar.addWidget(self.save_plot_button)
        plot_layout.addLayout(title_toolbar)
        plot_layout.addLayout(plot_toolbar)
        self.selection_view_box = SelectionViewBox()
        self.plot = pg.PlotWidget(viewBox=self.selection_view_box)
        self.plot.setBackground(BG)
        self.plot.showGrid(x=True, y=True, alpha=0.18)
        self.plot.setLabel("bottom", "Time after trigger", units="s")
        self.plot.getAxis("bottom").enableAutoSIPrefix(True)
        self.plot.setLabel("left", "Counts")
        self.plot.setMenuEnabled(True)
        self.plot.enableAutoRange(x=False, y=False)
        self.plot.setClipToView(True)
        self.plot.setDownsampling(auto=False)
        # Histogram counts cannot be negative. Prevent manual pan/zoom or
        # keyboard zoom from moving the MCS Y axis below zero.
        self.plot.setLimits(yMin=0.0)
        self.curve = self.plot.plot(
            pen=pg.mkPen(self.trace_color, width=1.25), connect="finite"
        )
        # Fixed full-spectrum overview. Main-view zoom never changes this scale.
        self.overview = FloatingOverview(self)
        self.overview.raise_()
        self.overview.show()
        self.overview_curve = pg.PlotCurveItem(pen=pg.mkPen(MUTED, width=1.0), connect="finite")
        self.overview.addItem(self.overview_curve)
        self.overview_zoom = pg.LinearRegionItem(values=(0, 1), movable=False,
            brush=pg.mkBrush(54, 197, 240, 55), pen=pg.mkPen(CYAN, width=1.2))
        self.overview.addItem(self.overview_zoom)
        self.overview.navigateRequested.connect(self._navigate_from_overview)
        self.plot.getViewBox().sigRangeChanged.connect(self._update_overview_zoom)
        QTimer.singleShot(0, self._position_overview)
        self.counter_trigger_view = pg.ViewBox()
        self.plot.scene().addItem(self.counter_trigger_view)
        self.counter_trigger_axis = self.plot.getAxis("right")
        self.counter_trigger_axis.linkToView(self.counter_trigger_view)
        # Reserve enough room for the independent trigger scale.  Relying on
        # AxisItem's automatic width can collapse this axis to almost nothing
        # after it has previously been hidden in MCS mode.
        self.counter_trigger_axis.setWidth(92)
        self.counter_trigger_axis.setStyle(
            showValues=True, tickLength=-5, autoExpandTextSpace=False,
            tickTextWidth=58,
        )
        self.counter_trigger_axis.setPen(pg.mkPen(self.counter_trigger_color))
        self.counter_trigger_axis.setTextPen(pg.mkPen(self.counter_trigger_color))
        self.counter_trigger_view.setXLink(self.plot)
        self.counter_trigger_view.setLimits(yMin=0.0)
        self.counter_trigger_curve = pg.PlotCurveItem(
            pen=pg.mkPen(self.counter_trigger_color, width=1.25), connect="finite",
            name="Trigger (H2)",
        )
        self.counter_trigger_view.addItem(self.counter_trigger_curve)
        self.plot.showAxis("right", show=False)
        self.counter_trigger_axis.setLabel(
            "Trigger input (H2)", units="cps", color=self.counter_trigger_color
        )
        self.counter_trigger_view.setVisible(False)
        self.counter_trigger_curve.setVisible(False)
        self.plot.getViewBox().sigResized.connect(
            self._sync_counter_trigger_view
        )
        self.signal_region = pg.LinearRegionItem(
            values=(10, 30), brush=pg.mkBrush(61, 220, 151, 42),
            pen=pg.mkPen(GREEN, width=1.5), movable=True,
        )
        self.noise_region = pg.LinearRegionItem(
            values=(70, 90), brush=pg.mkBrush(255, 180, 84, 38),
            pen=pg.mkPen(AMBER, width=1.5), movable=True,
        )
        self.signal_region.setZValue(5)
        self.noise_region.setZValue(4)
        self.plot.addItem(self.signal_region)
        self.plot.addItem(self.noise_region)
        self.highlight_region = pg.LinearRegionItem(
            values=(0, 1),
            brush=pg.mkBrush(54, 197, 240, 48),
            pen=pg.mkPen(CYAN, width=1.8),
            movable=False,
        )
        self.highlight_region.setZValue(6)
        self.highlight_region.setVisible(False)
        self.plot.addItem(self.highlight_region)
        self.difference_plot = pg.PlotWidget()
        self.difference_plot.setBackground(BG)
        self.difference_plot.showGrid(x=True, y=True, alpha=0.18)
        self.difference_plot.setLabel("bottom", "Time after trigger", units="s")
        self.difference_plot.getAxis("bottom").enableAutoSIPrefix(True)
        self.difference_plot.setLabel("left", "Net count rate", units="cps")
        self.difference_plot.setTitle("Signal − average noise")
        self.difference_plot.setMenuEnabled(True)
        self.difference_curve = self.difference_plot.plot(
            pen=pg.mkPen(GREEN, width=1.5), connect="finite"
        )
        self.plot_splitter = QSplitter(Qt.Orientation.Horizontal)
        self.plot_splitter.setChildrenCollapsible(True)
        self.plot_splitter.setHandleWidth(7)
        self.plot_splitter.addWidget(self.plot)
        self.plot_splitter.addWidget(self.difference_plot)
        self.difference_plot.setVisible(False)
        # Secondary analysis plots may follow their own data. The large MCS
        # histogram is deliberately handled separately and is fitted only once.
        self.difference_plot.enableAutoRange(x=True, y=True)
        self.rate_plot = pg.PlotWidget()
        self.rate_plot.setBackground(BG)
        self.rate_plot.showGrid(x=True, y=True, alpha=0.18)
        self.rate_plot.setLabel("bottom", "Elapsed acquisition time", units="s")
        self.rate_plot.setLabel("left", "Robust active-window rate", units="cps")
        self.rate_plot.setMenuEnabled(True)
        self.rate_curve = self.rate_plot.plot(
            pen=pg.mkPen(GREEN, width=1.5), connect="finite"
        )
        self.rate_plot.setMinimumHeight(80)
        self.rate_plot.setVisible(False)
        self.rate_plot.enableAutoRange(x=True, y=True)
        self.vertical_plot_splitter = QSplitter(Qt.Orientation.Vertical)
        self.vertical_plot_splitter.setChildrenCollapsible(True)
        self.vertical_plot_splitter.setHandleWidth(7)
        self.vertical_plot_splitter.addWidget(self.plot_splitter)
        self.vertical_plot_splitter.addWidget(self.rate_plot)
        self.vertical_plot_splitter.setStretchFactor(0, 4)
        self.vertical_plot_splitter.setStretchFactor(1, 1)
        self.vertical_plot_splitter.setSizes([620, 180])
        plot_layout.addWidget(self.vertical_plot_splitter, 1)
        left_workspace_layout.addWidget(plot_frame, 1)

        self.side_tabs = QTabWidget()
        analysis_tab = QWidget()
        side_layout = QVBoxLayout(analysis_tab)
        side_layout.setContentsMargins(4, 0, 4, 0)
        side_layout.setSpacing(10)
        self.roi_group = QGroupBox("Regions of interest")
        roi_layout = QGridLayout(self.roi_group)
        self.signal_start = self._region_spin(10)
        self.signal_end = self._region_spin(29)
        self.noise_start = self._region_spin(70)
        self.noise_end = self._region_spin(89)
        signal_swatch = QLabel("● Signal")
        signal_swatch.setStyleSheet(f"color:{GREEN}; font-weight:600")
        noise_swatch = QLabel("● Noise / background")
        noise_swatch.setStyleSheet(f"color:{AMBER}; font-weight:600")
        roi_layout.addWidget(signal_swatch, 0, 0, 1, 2)
        roi_layout.addWidget(QLabel("First bin"), 1, 0)
        roi_layout.addWidget(QLabel("Last bin"), 1, 1)
        roi_layout.addWidget(self.signal_start, 2, 0)
        roi_layout.addWidget(self.signal_end, 2, 1)
        roi_layout.addWidget(noise_swatch, 3, 0, 1, 2)
        roi_layout.addWidget(QLabel("First bin"), 4, 0)
        roi_layout.addWidget(QLabel("Last bin"), 4, 1)
        roi_layout.addWidget(self.noise_start, 5, 0)
        roi_layout.addWidget(self.noise_end, 5, 1)
        self.reset_regions_button = QPushButton("Reset regions")
        roi_layout.addWidget(self.reset_regions_button, 6, 0, 1, 2)
        help_label = QLabel(
            "Drag either shaded region on the plot, or enter inclusive bin limits. "
            "Noise is scaled by region width before background subtraction."
        )
        help_label.setObjectName("HintLabel")
        help_label.setWordWrap(True)
        roi_layout.addWidget(help_label, 7, 0, 1, 2)
        side_layout.addWidget(self.roi_group)

        self.analysis_group = QGroupBox("Live ROI analysis")
        analysis_grid = QGridLayout(self.analysis_group)
        self.metric_signal = MetricValue("Gross signal")
        self.metric_background = MetricValue("Estimated background")
        self.metric_net = MetricValue("Net signal rate")
        self.metric_snr = MetricValue("SNR")
        self.metric_noise = MetricValue("Noise / bin")
        self.metric_rate = MetricValue("Net integrated counts")
        analysis_grid.addWidget(self.metric_signal, 0, 0)
        analysis_grid.addWidget(self.metric_background, 0, 1)
        analysis_grid.addWidget(self.metric_net, 1, 0)
        analysis_grid.addWidget(self.metric_snr, 1, 1)
        analysis_grid.addWidget(self.metric_noise, 2, 0)
        analysis_grid.addWidget(self.metric_rate, 2, 1)
        self.roi_detail = QLabel("No histogram available")
        self.roi_detail.setObjectName("HintLabel")
        self.roi_detail.setWordWrap(True)
        analysis_grid.addWidget(self.roi_detail, 3, 0, 1, 2)
        side_layout.addWidget(self.analysis_group)

        frame_group = QGroupBox("Acquisition status")
        self.frame_group = frame_group
        frame_form = QFormLayout(frame_group)
        frame_form.setFieldGrowthPolicy(QFormLayout.FieldGrowthPolicy.AllNonFixedFieldsGrow)
        frame_form.setRowWrapPolicy(QFormLayout.RowWrapPolicy.WrapLongRows)
        frame_form.setHorizontalSpacing(12)
        frame_form.setVerticalSpacing(5)
        self.frame_passes = QLabel("—")
        self.frame_bins = QLabel("—")
        self.frame_dwell = QLabel("—")
        self.frame_span = QLabel("—")
        self.frame_total = QLabel("—")
        self.frame_rate = QLabel("—")
        self.frame_wire_limit = QLabel("—")
        self.frame_integrity = QLabel("—")
        self.frame_integrity.setWordWrap(True)
        frame_form.addRow("FPGA passes", self.frame_passes)
        frame_form.addRow("Bins", self.frame_bins)
        frame_form.addRow("Dwell", self.frame_dwell)
        frame_form.addRow("Acquisition span", self.frame_span)
        frame_form.addRow("Displayed counts", self.frame_total)
        frame_form.addRow("Frame rate", self.frame_rate)
        frame_form.addRow("5 Mbaud limit", self.frame_wire_limit)
        frame_form.addRow("Last frame", self.frame_integrity)
        self.frame_bytes = QLabel("—")
        frame_form.addRow("Frame size", self.frame_bytes)
        self.acquisition_elapsed = QLabel("—")
        self.acquisition_pass_rate = QLabel("—")
        self.acquisition_count_rate = QLabel("—")
        self.acquisition_time_left = QLabel("—")
        self.acquisition_finish_time = QLabel("—")
        frame_form.addRow("Acquisition time", self.acquisition_elapsed)
        frame_form.addRow("Pass rate", self.acquisition_pass_rate)
        frame_form.addRow("Active-window count rate", self.acquisition_count_rate)
        frame_form.addRow("Time remaining", self.acquisition_time_left)
        frame_form.addRow("Estimated completion", self.acquisition_finish_time)

        # Stable keys used by Data Settings. The label text may be customized
        # without changing the underlying measurement source.
        self.status_fields = {
            "fpga_passes": ("FPGA passes", self.frame_passes),
            "bins": ("Bins", self.frame_bins),
            "dwell": ("Dwell", self.frame_dwell),
            "span": ("Acquisition span", self.frame_span),
            "displayed_counts": ("Displayed counts", self.frame_total),
            "frame_rate": ("Frame rate", self.frame_rate),
            "wire_limit": ("5 Mbaud limit", self.frame_wire_limit),
            "integrity": ("Last frame", self.frame_integrity),
            "frame_size": ("Frame size", self.frame_bytes),
            "acq_time": ("Acquisition time", self.acquisition_elapsed),
            "pass_rate": ("Pass rate", self.acquisition_pass_rate),
            "count_rate": ("Active-window count rate", self.acquisition_count_rate),
            "time_remaining": ("Time remaining", self.acquisition_time_left),
            "completion": ("Estimated completion", self.acquisition_finish_time),
        }
        for _label, value_widget in self.status_fields.values():
            value_widget.setWordWrap(True)

        self.counter_status_group = QGroupBox("Simple counter statistics")
        counter_status_form = QFormLayout(self.counter_status_group)
        self.counter_stat_current = QLabel("—")
        self.counter_stat_trigger_current = QLabel("—")
        self.counter_stat_mean = QLabel("—")
        self.counter_stat_std = QLabel("—")
        self.counter_stat_rsd = QLabel("—")
        self.counter_stat_min = QLabel("—")
        self.counter_stat_max = QLabel("—")
        self.counter_stat_elapsed = QLabel("—")
        self.counter_stat_samples = QLabel("0")
        counter_status_form.addRow("Signal CPS (H4)", self.counter_stat_current)
        counter_status_form.addRow("Trigger CPS (H2)", self.counter_stat_trigger_current)
        counter_status_form.addRow("Mean CPS", self.counter_stat_mean)
        counter_status_form.addRow("Std. deviation", self.counter_stat_std)
        counter_status_form.addRow("Relative std. dev.", self.counter_stat_rsd)
        counter_status_form.addRow("Minimum CPS", self.counter_stat_min)
        counter_status_form.addRow("Maximum CPS", self.counter_stat_max)
        counter_status_form.addRow("Elapsed time", self.counter_stat_elapsed)
        counter_status_form.addRow("Saved samples", self.counter_stat_samples)
        self.counter_status_group.setVisible(False)
        status_tab = QWidget()
        status_layout = QVBoxLayout(status_tab)
        status_layout.setContentsMargins(8, 8, 8, 8)
        status_layout.setSpacing(10)
        status_layout.addWidget(frame_group)
        status_layout.addWidget(self.counter_status_group)
        status_layout.addStretch(1)
        side_layout.addStretch(1)
        self.side_tabs.addTab(status_tab, "Status")
        self.side_tabs.addTab(analysis_tab, "ROI analysis")
        # Wide enough that status labels never truncate; no fixed maximum so
        # the user can drag the splitter wider on large displays.
        self.side_tabs.setMinimumWidth(360)
        self.workspace_splitter.addWidget(self.side_tabs)
        self.workspace_splitter.setStretchFactor(0, 1)
        self.workspace_splitter.setStretchFactor(1, 0)
        self.workspace_splitter.setSizes([1120, 400])

        self.selection_panel = QFrame()
        self.selection_panel.setObjectName("SelectionPanel")
        selection_layout = QHBoxLayout(self.selection_panel)
        selection_layout.setContentsMargins(10, 5, 10, 5)
        selection_caption = QLabel("Highlighted section")
        selection_caption.setObjectName("SelectionCaption")
        self.selection_info = QLabel(
            "Hold Ctrl and left-click a bin, or Ctrl+drag across a range"
        )
        self.selection_info.setObjectName("SelectionInfo")
        self.selection_info.setWordWrap(True)
        self.selection_info.setMinimumHeight(42)
        self.selection_info.setTextInteractionFlags(
            Qt.TextInteractionFlag.TextSelectableByMouse
        )
        selection_layout.addWidget(selection_caption)
        selection_layout.addWidget(self.selection_info, 1)
        plot_index = left_workspace_layout.indexOf(plot_frame)
        left_workspace_layout.insertWidget(max(0, plot_index), self.selection_panel)

        status = QStatusBar()
        self.setStatusBar(status)
        self.status_message = QLabel("Ready — connect an instrument")
        self.x_axis_label = QLabel("X axis")
        self.x_axis_label.setObjectName("HintLabel")
        self.x_axis_combo = QComboBox()
        self.x_axis_combo.addItem("Time", "time")
        self.x_axis_combo.addItem("Bin", "bin")
        self.x_axis_combo.setToolTip("Display the MCS horizontal axis as physical time or bin number")
        self.status_clock = QLabel("100 MHz · 10.000 ns/clock")
        self.status_clock.setObjectName("HintLabel")
        self.status_timing = QLabel("Acquisition — · ETA —")
        self.status_timing.setObjectName("HintLabel")
        self.status_frame_kind = QLabel("NO DATA")
        self.status_frame_kind.setObjectName("HintLabel")
        status.addWidget(self.status_message, 1)
        status.addPermanentWidget(self.status_frame_kind)
        status.addPermanentWidget(self.status_timing)
        status.addPermanentWidget(self.x_axis_label)
        status.addPermanentWidget(self.x_axis_combo)
        status.addPermanentWidget(self.status_clock)
        # PlotWidget is a QGraphicsView and normally consumes wheel events for
        # zooming. In this scrollable interface, the wheel always belongs to
        # the page. Dragging and the explicit zoom shortcuts still operate on
        # the plots.
        self._page_scroll_wheel_targets = {
            self.plot.viewport(),
            self.difference_plot.viewport(),
            self.rate_plot.viewport(),
        }
        for target in self._page_scroll_wheel_targets:
            target.installEventFilter(self)
        self._initialize_layout_editor_model()
        self._update_quantization()

    def _region_spin(self, value):
        spin = QSpinBox()
        spin.setRange(0, MAX_BINS - 1)
        spin.setGroupSeparatorShown(True)
        spin.setValue(value)
        return spin

    def _connect_signals(self):
        self.setup_button.clicked.connect(self._show_acquisition_popup)
        self.layout_button.clicked.connect(self._show_layout_editor)
        self.shortcuts_button.toggled.connect(self._toggle_shortcuts_window)
        self.theme_combo.currentIndexChanged.connect(self._apply_theme)
        self.help_button.clicked.connect(self.show_help)
        self.quick_run_button.clicked.connect(self.start_run)
        self.quick_stop_button.clicked.connect(self.stop_run)
        self.quick_clear_button.clicked.connect(self.reset_histogram)
        self.refresh_button.clicked.connect(self.refresh_ports)
        self.connect_button.clicked.connect(self.toggle_connection)
        self.configure_button.clicked.connect(self.configure_acquisition)
        self.trigger_edge_combo.currentIndexChanged.connect(self._apply_trigger_edge)
        self.run_button.clicked.connect(self.start_run)
        self.external_button.clicked.connect(self.start_external)
        self.stop_button.clicked.connect(self.stop_run)
        self.single_button.clicked.connect(self.single_trigger)
        self.reset_button.clicked.connect(self.reset_histogram)
        self.save_csv_button.clicked.connect(self.save_csv)
        self.save_plot_button.clicked.connect(self.save_plot)
        self.browse_save_directory_button.clicked.connect(self._browse_save_directory)
        self.data_settings_button.clicked.connect(self._show_data_settings)
        self.save_data_button.clicked.connect(self.save_data)
        self.trace_color_button.clicked.connect(self.choose_trace_color)
        self.clock_frequency_apply_button.clicked.connect(
            self._apply_clock_frequency
        )
        self.clock_frequency_reset_button.clicked.connect(
            self._reset_clock_frequency
        )
        self.counter_signal_color_button.clicked.connect(
            self.choose_counter_signal_color
        )
        self.counter_trigger_color_button.clicked.connect(
            self.choose_counter_trigger_color
        )
        self.mcs_mode_button.clicked.connect(lambda: self._set_mode("mcs"))
        self.counter_mode_button.clicked.connect(lambda: self._set_mode("counter"))
        self.self_test_check.toggled.connect(self._self_test_setting_changed)
        self.counter_self_test_check.toggled.connect(self._counter_self_test_setting_changed)
        self.unlimited_passes_check.toggled.connect(
            lambda enabled: self.max_passes_spin.setEnabled(not enabled)
        )
        self.internal_signal_check.toggled.connect(self._internal_signal_changed)
        self.x_axis_combo.currentIndexChanged.connect(self._x_axis_changed)
        self.selection_view_box.selectionDragged.connect(
            self._highlight_plot_section
        )
        self.plot.scene().sigMouseClicked.connect(self._plot_mouse_clicked)
        self.dwell_spin.valueChanged.connect(self._update_quantization)
        self.dwell_unit.currentIndexChanged.connect(self._mcs_limits_changed)
        self.bins_spin.valueChanged.connect(self._mcs_limits_changed)
        self.auto_y_check.toggled.connect(self._set_live_fit_y)
        self.log_y_check.toggled.connect(self._apply_display_options)
        self.plot_rate_check.toggled.connect(self._set_rate_plot_enabled)
        self.clear_rate_button.clicked.connect(self._clear_mcs_rate_history)
        self.counter_signal_check.toggled.connect(
            self._update_counter_trace_visibility
        )
        self.counter_trigger_check.toggled.connect(
            self._update_counter_trace_visibility
        )
        self.roi_enable_check.toggled.connect(self._set_roi_enabled)
        self.difference_button.toggled.connect(self._set_difference_enabled)
        self.reference_button.clicked.connect(self._freeze_reference_histogram)
        self.clear_reference_button.clicked.connect(self._clear_reference_histogram)
        self.signal_region.sigRegionChangeFinished.connect(lambda: self._region_dragged("signal"))
        self.noise_region.sigRegionChangeFinished.connect(lambda: self._region_dragged("noise"))
        for spin in (self.signal_start, self.signal_end, self.noise_start, self.noise_end):
            spin.valueChanged.connect(self._spins_changed)
        self.reset_regions_button.clicked.connect(self.reset_regions)

    def _restore_settings(self):
        self.auto_connect_check.setChecked(self.settings.value("connection/auto", True, type=bool))
        self._load_data_settings()
        default_save_dir = str(Path.home() / "Documents" / "OpenMCS Data")
        self.save_directory_edit.setText(
            self.settings.value("data/save_directory", default_save_dir, str)
        )
        self.run_name_edit.setText(
            self.settings.value("data/run_name", "sample_001", str)
        )
        self.save_image_check.setChecked(
            self.settings.value("data/save_image", True, type=bool)
        )
        self.bins_spin.setValue(
            self.settings.value("acquisition/bins", DEFAULT_BINS, int)
        )
        self.dwell_spin.setValue(self.settings.value("acquisition/dwell_value", 100.0, float))
        self.dwell_unit.setCurrentIndex(self.settings.value("acquisition/dwell_unit", 0, int))
        self.trigger_spin.setValue(self.settings.value("acquisition/trigger_hz", 100, int))
        saved_edge = self.settings.value("acquisition/trigger_edge", "r", str)
        edge_index = self.trigger_edge_combo.findData(saved_edge)
        self.trigger_edge_combo.setCurrentIndex(max(0, edge_index))
        self.max_passes_spin.setValue(
            self.settings.value("acquisition/max_passes", 5_000, int)
        )
        self.unlimited_passes_check.setChecked(
            self.settings.value("acquisition/unlimited_passes", False, type=bool)
        )
        self.max_passes_spin.setEnabled(not self.unlimited_passes_check.isChecked())
        self.test_passes_spin.setValue(
            self.settings.value("acquisition/self_test_passes", 5_000, int)
        )
        saved_mode = self.settings.value("acquisition/mode", "mcs", str)
        self.signal_start.setValue(self.settings.value("roi/signal_start", 10, int))
        self.signal_end.setValue(self.settings.value("roi/signal_end", 29, int))
        self.noise_start.setValue(self.settings.value("roi/noise_start", 70, int))
        self.noise_end.setValue(self.settings.value("roi/noise_end", 89, int))
        self.roi_enable_check.setChecked(
            self.settings.value("roi/visible_v2", False, type=bool)
        )
        self.counter_dwell_spin.setValue(
            self.settings.value("counter/dwell_seconds", 0.100, float)
        )
        theme = self.settings.value("appearance/theme", "dark", str)
        self.theme_combo.setCurrentIndex(max(0, self.theme_combo.findData(theme)))
        self._set_trace_color(
            self.settings.value("appearance/trace_color", CYAN, str)
        )
        self._set_counter_signal_color(
            self.settings.value("appearance/counter_signal_color", CYAN, str)
        )
        self._set_counter_trigger_color(
            self.settings.value("appearance/counter_trigger_color", AMBER, str)
        )
        self.counter_signal_check.setChecked(
            self.settings.value("appearance/show_counter_signal", True, type=bool)
        )
        self.counter_trigger_check.setChecked(
            self.settings.value("appearance/show_counter_trigger", True, type=bool)
        )
        self.plot_rate_check.setChecked(
            self.settings.value("appearance/plot_count_rate", True, type=bool)
        )
        self._set_roi_enabled(self.roi_enable_check.isChecked())
        self._spins_changed()
        legacy_self_test = saved_mode == "self_test"
        self._set_mode(saved_mode if saved_mode in ("mcs", "counter") else "mcs")
        self.self_test_check.setChecked(
            legacy_self_test or self.settings.value(
                "acquisition/self_test", False, type=bool
            )
        )
        with QSignalBlocker(self.counter_self_test_check):
            self.counter_self_test_check.setChecked(self.self_test_check.isChecked())
        self.internal_signal_check.setChecked(
            self.settings.value("acquisition/internal_signal", False, type=bool)
        )
        self.clock_frequency_hz = self.settings.value(
            "calibration/clock_hz", float(EXPECTED_CLOCK_HZ), float
        )
        self.clock_frequency_spin.setValue(self.clock_frequency_hz / 1e6)
        saved_x_axis = self.settings.value("appearance/x_axis", "time", str)
        x_axis_index = self.x_axis_combo.findData(saved_x_axis)
        self.x_axis_combo.setCurrentIndex(max(0, x_axis_index))
        self._mcs_limits_changed()
        self._update_clock_status()
        workspace_state = self.settings.value("layout/workspace_splitter")
        vertical_state = self.settings.value("layout/vertical_plot_splitter")
        plot_state = self.settings.value("layout/plot_splitter")
        if workspace_state is not None:
            self.workspace_splitter.restoreState(workspace_state)
        if vertical_state is not None:
            self.vertical_plot_splitter.restoreState(vertical_state)
        if plot_state is not None:
            self.plot_splitter.restoreState(plot_state)
        self._restore_layout_customization()

    def _save_settings(self):
        values = {
            "connection/auto": self.auto_connect_check.isChecked(),
            "connection/port": self.port_combo.currentData() or "",
            "data/save_directory": self.save_directory_edit.text().strip(),
            "data/run_name": self.run_name_edit.text().strip(),
            "data/save_image": self.save_image_check.isChecked(),
            "acquisition/bins": self.bins_spin.value(),
            "acquisition/dwell_value": self.dwell_spin.value(),
            "acquisition/dwell_unit": self.dwell_unit.currentIndex(),
            "acquisition/trigger_hz": self.trigger_spin.value(),
            "acquisition/trigger_edge": self.trigger_edge_combo.currentData() or "r",
            "acquisition/max_passes": self.max_passes_spin.value(),
            "acquisition/unlimited_passes": self.unlimited_passes_check.isChecked(),
            "acquisition/self_test_passes": self.test_passes_spin.value(),
            "acquisition/mode": self.instrument_mode,
            "acquisition/self_test": self.self_test_check.isChecked(),
            "acquisition/internal_signal": self.internal_signal_check.isChecked(),
            "counter/dwell_seconds": self.counter_dwell_spin.value(),
            "appearance/theme": self.theme_combo.currentData(),
            "appearance/trace_color": self.trace_color,
            "appearance/counter_signal_color": self.counter_signal_color,
            "appearance/counter_trigger_color": self.counter_trigger_color,
            "appearance/show_counter_signal": self.counter_signal_check.isChecked(),
            "appearance/show_counter_trigger": self.counter_trigger_check.isChecked(),
            "appearance/plot_count_rate": self.plot_rate_check.isChecked(),
            "appearance/x_axis": self.x_axis_combo.currentData() or "time",
            "calibration/clock_hz": self.clock_frequency_hz,
            "roi/signal_start": self.signal_start.value(),
            "roi/signal_end": self.signal_end.value(),
            "roi/noise_start": self.noise_start.value(),
            "roi/noise_end": self.noise_end.value(),
            "roi/visible_v2": self.roi_enable_check.isChecked(),
        }
        for key, value in values.items():
            self.settings.setValue(key, value)
        self.settings.setValue(
            "layout/workspace_splitter", self.workspace_splitter.saveState()
        )
        self.settings.setValue(
            "layout/vertical_plot_splitter", self.vertical_plot_splitter.saveState()
        )
        self.settings.setValue("layout/plot_splitter", self.plot_splitter.saveState())
        self._save_layout_customization()

    def _install_shortcuts(self):
        self.shortcuts = []

        def bind(keys, callback):
            shortcut = QShortcut(QKeySequence(keys), self)
            shortcut.activated.connect(callback)
            self.shortcuts.append(shortcut)

        bind("F1", self.show_help)
        bind("F5", self.start_run)
        bind("Shift+F5", self.stop_run)
        bind("Escape", self.stop_run)
        bind("Ctrl+Return", self.configure_acquisition)
        bind("Ctrl+L", self.reset_histogram)
        bind("Ctrl+S", self.save_csv)
        bind("Ctrl+Shift+S", self.save_plot)
        bind("Ctrl+Shift+D", self.save_data)
        bind("Ctrl+R", self.roi_enable_check.toggle)
        bind("Ctrl+D", self.difference_button.toggle)
        bind("Ctrl+Y", self._fit_y_once)
        bind("Ctrl+A", self._auto_range_mcs_live)
        bind("Ctrl+G", self.log_y_check.toggle)
        bind("Ctrl+,", self._show_acquisition_popup)
        bind("F2", self._show_acquisition_popup)
        bind("Ctrl+1", lambda: self._set_mode("mcs"))
        bind("Ctrl+2", lambda: self._set_mode("counter"))
        bind("Ctrl+3", self._toggle_self_test)
        bind("Ctrl+F", self._freeze_reference_histogram)
        bind("Ctrl+Shift+F", self._clear_reference_histogram)

        # Keyboard histogram navigation. Plain arrows move the selected bin.
        # Ctrl+arrows zoom around that selected bin without changing selection.
        for key, step in (
            ("Left", -1), ("Right", 1),
            ("Up", 1), ("Down", -1),
        ):
            shortcut = QShortcut(QKeySequence(key), self)
            shortcut.setContext(Qt.ShortcutContext.ApplicationShortcut)
            shortcut.activated.connect(
                lambda step=step: self._move_highlighted_bin(step)
            )
            self.shortcuts.append(shortcut)

        # Ctrl+horizontal arrows affect only the X axis.
        # Ctrl+vertical arrows affect only the Y axis.
        for key, axis, factor in (
            ("Ctrl+Right", "x", 0.5),   # X zoom in
            ("Ctrl+Left",  "x", 2.0),   # X zoom out
            ("Ctrl+Up",    "y", 0.5),   # Y zoom in
            ("Ctrl+Down",  "y", 2.0),   # Y zoom out
        ):
            shortcut = QShortcut(QKeySequence(key), self)
            shortcut.setContext(Qt.ShortcutContext.ApplicationShortcut)
            shortcut.activated.connect(
                lambda axis=axis, factor=factor:
                    self._zoom_around_selected_bin(axis, factor)
            )
            self.shortcuts.append(shortcut)

    def _apply_theme(self, _index=None):
        theme = self.theme_combo.currentData() or "dark"
        app = QApplication.instance()
        if app is not None:
            app.setStyleSheet(DARK_STYLE_SHEET if theme == "dark" else LIGHT_STYLE_SHEET)
        plot_background = BG if theme == "dark" else LIGHT_BG
        axis_color = MUTED if theme == "dark" else "#526579"
        for plot in (self.plot, self.difference_plot, self.rate_plot):
            plot.setBackground(plot_background)
            for axis_name in ("left", "bottom"):
                axis = plot.getAxis(axis_name)
                axis.setTextPen(axis_color)
                axis.setPen(axis_color)

        # The overview is part of the same visual system as the main plot.
        # It is opaque in both themes and uses the theme's panel/border colors.
        if hasattr(self, "overview"):
            inset_bg = PANEL if theme == "dark" else "#ffffff"
            inset_border = BORDER if theme == "dark" else "#a8b6c5"
            self.overview.setThemeColors(inset_bg, inset_border)
            self.overview_curve.setPen(pg.mkPen(axis_color, width=1.0))
            highlight = QColor(CYAN)
            highlight.setAlpha(58 if theme == "dark" else 42)
            self.overview_zoom.setBrush(pg.mkBrush(highlight))
            # LinearRegionItem has no setPen() in several supported
            # pyqtgraph releases. Its two InfiniteLine boundaries own the pen.
            boundary_pen = pg.mkPen(CYAN, width=1.5)
            for boundary_line in self.overview_zoom.lines:
                boundary_line.setPen(boundary_pen)
        # Channel colors are explicit user choices and must not be derived
        # from either the selected GUI theme or the operating-system theme.
        if self.instrument_mode == "counter":
            self.plot.getAxis("left").setTextPen(self.counter_signal_color)
            self.plot.getAxis("left").setPen(self.counter_signal_color)
        self.counter_trigger_axis.setTextPen(self.counter_trigger_color)
        self.counter_trigger_axis.setPen(self.counter_trigger_color)

    def choose_trace_color(self):
        color = QColorDialog.getColor(
            QColor(self.trace_color), self, "Choose MCS trace color",
            QColorDialog.ColorDialogOption.DontUseNativeDialog,
        )
        if color.isValid():
            self._set_trace_color(color.name())

    def _set_trace_color(self, color_name):
        color = QColor(str(color_name))
        if not color.isValid():
            color = QColor(CYAN)
        self.trace_color = color.name()
        if self.instrument_mode == "mcs":
            self.curve.setPen(pg.mkPen(self.trace_color, width=1.25))
        text_color = "#081018" if color.lightness() > 150 else "#ffffff"
        self.trace_color_button.setText(f"Trace  {self.trace_color.upper()}")
        self.trace_color_button.setStyleSheet(
            f"background:{self.trace_color}; color:{text_color}; "
            f"border:1px solid {self.trace_color}; font-weight:650;"
        )

    def choose_counter_signal_color(self):
        color = QColorDialog.getColor(
            QColor(self.counter_signal_color), self, "Choose H4 Signal color",
            QColorDialog.ColorDialogOption.DontUseNativeDialog,
        )
        if color.isValid():
            self._set_counter_signal_color(color.name())

    def choose_counter_trigger_color(self):
        color = QColorDialog.getColor(
            QColor(self.counter_trigger_color), self, "Choose H2 Trigger color",
            QColorDialog.ColorDialogOption.DontUseNativeDialog,
        )
        if color.isValid():
            self._set_counter_trigger_color(color.name())

    @staticmethod
    def _color_button_style(color):
        text = "#081018" if QColor(color).lightness() > 150 else "#ffffff"
        return (
            f"background:{color}; color:{text}; border:1px solid {color}; "
            "font-weight:800; padding:0;"
        )

    def _set_counter_signal_color(self, color_name):
        color = QColor(str(color_name))
        if not color.isValid():
            color = QColor(CYAN)
        self.counter_signal_color = color.name()
        if self.instrument_mode == "counter":
            self.curve.setPen(pg.mkPen(self.counter_signal_color, width=1.25))
            self.plot.getAxis("left").setPen(self.counter_signal_color)
            self.plot.getAxis("left").setTextPen(self.counter_signal_color)
            self.plot.setLabel(
                "left", "Signal input (H4)", units="cps",
                color=self.counter_signal_color,
            )
        self.counter_signal_color_button.setStyleSheet(
            self._color_button_style(self.counter_signal_color)
        )

    def _set_counter_trigger_color(self, color_name):
        color = QColor(str(color_name))
        if not color.isValid():
            color = QColor(AMBER)
        self.counter_trigger_color = color.name()
        self.counter_trigger_curve.setPen(
            pg.mkPen(self.counter_trigger_color, width=1.25)
        )
        self.counter_trigger_axis.setPen(pg.mkPen(self.counter_trigger_color))
        self.counter_trigger_axis.setTextPen(pg.mkPen(self.counter_trigger_color))
        self.counter_trigger_axis.setLabel(
            "Trigger input (H2)", units="cps",
            color=self.counter_trigger_color,
        )
        self.counter_trigger_color_button.setStyleSheet(
            self._color_button_style(self.counter_trigger_color)
        )

    def show_help(self):
        QMessageBox.information(
            self,
            "OpenMCS help",
            "<h2>OpenMCS quick help</h2>"
            "<p><b>Mode:</b> use the always-visible MCS / COUNTER switch at the top. "
            "Changing mode safely stops a running acquisition. Ctrl+1 selects MCS; "
            "Ctrl+2 selects Counter; Ctrl+3 toggles the MCS Self test setting.</p>"
            "<p><b>Trace colors:</b> MCS uses its Trace button. In Counter mode, "
            "H4 Signal (L) and H2 Trigger (R) can each be shown or hidden, and "
            "the small colored button beside each channel changes its color.</p>"
            "<p><b>Setup</b> reveals bins, dwell, trigger, and counter settings. "
            "Keep it collapsed for a plot-focused acquisition view.</p>"
            "<p><b>Saving:</b> choose a Save to folder and Run name once, then use Save Data to write both CSV and PNG without another dialog. Existing names are protected with _002, _003, etc.</p>"
            "<p><b>MCS:</b> set Max passes (or Continuous / unlimited), apply the configuration, then use Run internal, "
            "Run external, or Stop. MCS dwell is limited to 1 ms/bin and each pass to 20 s total. The horizontal axis is physical time after trigger.</p>"
            "<p><b>Counter:</b> choose Simple counter, select the active dwell, "
            "then Start counter. No external trigger source is required.</p>"
            "<p><b>Self Test:</b> select MCS, enable Self test in Setup, click Prepare self-test, "
            "the dwell time and pass count, then click Start self-test. The stimulus "
            "continues independently while the FPGA accepts the selected passes. It generates one event/pass in bins "
            "4, 49, 499, and 3,999 for the selected dwell.</p>"
            "<p><b>ROI:</b> enable ROI, drag signal and noise regions, and optionally "
            "enable Difference for a side-by-side background-subtracted CPS plot.</p>"
            "<p><b>Interactive inspection:</b> Ctrl+left-click selects one bin; hold Ctrl and left-drag across "
            "the histogram. The highlighted interval and its bin/time range, "
            "sum, mean, peak, and centroid appear below the plot.</p>"
            "<h3>Keyboard shortcuts</h3>"
            "<pre>F5          Start acquisition\n"
            "Shift+F5    Stop acquisition\n"
            "Esc         Stop and disarm\n"
            "Ctrl+Enter  Apply/prepare configuration\n"
            "Ctrl+L      Clear accumulation\n"
            "Ctrl+S      Export CSV\n"
            "Ctrl+Shift+S Export plot image\n"
            "←/→ ↑/↓     Move selected bin by one\n"
            "Ctrl+→      Zoom X axis in around selected bin\n"
            "Ctrl+←      Zoom X axis out around selected bin\n"
            "Ctrl+↑      Zoom Y axis in around selected bin\n"
            "Ctrl+↓      Zoom Y axis out around selected bin\n"
            "Ctrl+R      Toggle ROI\n"
            "Ctrl+D      Toggle difference plot\n"
            "Ctrl+Y      Toggle Auto Y\n"
            "Ctrl+G      Toggle Log Y\n"
            "Ctrl+, / F2 Open setup\n"
            "Ctrl+1/2    MCS/counter mode\n"
            "Ctrl+3      Toggle MCS self-test setting\n"
            "F1          Help</pre>"
        )

    def refresh_ports(self):
        if self.worker is not None:
            return
        current = self.port_combo.currentData()
        preferred = current or self.settings.value("connection/port", "", str)
        ports = available_ports()
        self.port_combo.clear()
        for port in ports:
            self.port_combo.addItem(f"{port.device} — {port.description}", port.device)
        if preferred:
            index = self.port_combo.findData(preferred)
            if index >= 0:
                self.port_combo.setCurrentIndex(index)
        self.connect_button.setEnabled(bool(ports))
        if not ports:
            self._show_status("No serial instruments detected", "warning")

    def _try_initial_auto_connect(self):
        if self._auto_connect_attempted or not self.auto_connect_check.isChecked():
            return
        self._auto_connect_attempted = True
        if self.port_combo.count() and self.worker is None:
            self.toggle_connection()

    def toggle_connection(self):
        if self.worker is not None:
            self.disconnect_serial()
            return
        port_name = self.port_combo.currentData()
        if not port_name:
            self._show_status("Select a COM port first", "warning")
            return
        self.connect_button.setEnabled(False)
        self._show_status(f"Connecting to {port_name}…")
        worker = SerialWorker(port_name)
        worker.frame_received.connect(self.handle_frame)
        worker.connection_changed.connect(self.handle_connection)
        worker.message.connect(self._show_status)
        self.worker = worker
        worker.start()

    def disconnect_serial(self):
        if self.worker is None:
            return
        self._show_status("Disconnecting…")
        self.worker.stop()
        if not self.worker.wait(1500):
            self._show_status("Serial connection is taking longer to close", "warning")

    def handle_connection(self, connected, port_name):
        if connected:
            self._set_connected(True)
            self.send(f"g {1 if self.internal_signal_check.isChecked() else 0}")
            self.send(f"h {1 if self.self_test_check.isChecked() else 0}")
            self._apply_trigger_edge()
            self._show_status(f"Connected to {port_name}", "success")
        else:
            if self.sender() is self.worker:
                self.worker = None
            self._set_connected(False)
            self.acquisition_running = False
            self._finish_acquisition_timing()
            self.configured_signature = None
            self._show_status("Disconnected", "warning")
            QTimer.singleShot(0, self.refresh_ports)

    def _set_connected(self, connected):
        self.connect_button.setText("Disconnect" if connected else "Connect")
        self.connect_button.setEnabled(connected or self.port_combo.count() > 0)
        self.port_combo.setEnabled(not connected)
        self.refresh_button.setEnabled(not connected)
        for widget in (self.configure_button, self.run_button, self.external_button,
                       self.stop_button,
                       self.single_button, self.quick_run_button,
                       self.quick_stop_button, self.quick_clear_button):
            widget.setEnabled(connected)
        if self.instrument_mode == "counter" or self.self_test_check.isChecked():
            self.single_button.setEnabled(False)
        self.connection_badge.setText("●  CONNECTED" if connected else "●  DISCONNECTED")
        self.connection_badge.setProperty("connected", connected)
        self.connection_badge.style().unpolish(self.connection_badge)
        self.connection_badge.style().polish(self.connection_badge)
        has_data = (
            bool(self.counter_times)
            if self.instrument_mode == "counter"
            else self.latest_counts is not None
        )
        self.save_csv_button.setEnabled(has_data)
        self.save_plot_button.setEnabled(has_data)
        self.reset_button.setEnabled(connected)

    def send(self, command):
        if self.worker is None:
            self._show_status("Connect to the Teensy first", "warning")
            return False
        self.worker.send_command(command)
        return True

    def _mcs_max_dwell_seconds(self):
        """Maximum dwell representable by the existing 32-bit FPGA protocol."""
        return 0xFFFFFFFF / self._clock_hz()

    def _mcs_limits_changed(self, _value=None):
        """Expose the full dwell range supported by the existing GUI/FPGA protocol."""
        multiplier = float(self.dwell_unit.currentData() or 1.0)
        max_seconds = self._mcs_max_dwell_seconds()
        max_display = max_seconds / multiplier
        self.dwell_spin.setMaximum(max_display)
        if self.dwell_spin.value() > max_display:
            self.dwell_spin.setValue(max_display)
        self.dwell_spin.setToolTip(
            f"Full 32-bit dwell range: up to {max_seconds:,.6f} s/bin at "
            f"{self._clock_hz()/1e6:,.6f} MHz. No GUI 1 ms/bin or 20 s/pass limit."
        )
        self._update_quantization()

    def _validate_mcs_timing(self):
        """GUI imposes no legacy dwell/pass-span limit; protocol range is enforced on conversion."""
        return True

    def _requested_dwell_cycles(self):
        seconds = self.dwell_spin.value() * self.dwell_unit.currentData()
        return max(MIN_DWELL_CYCLES, min(0xFFFFFFFF, round(seconds * self._clock_hz())))

    def _counter_timing(self):
        """Return segment cycles/count and actual displayed Counter dwell."""
        requested_s = float(self.counter_dwell_spin.value())
        total_cycles = max(MIN_DWELL_CYCLES, round(requested_s * self._clock_hz()))
        segments = max(1, math.ceil(total_cycles / 0xFFFFFFFF))
        segment_cycles = max(
            MIN_DWELL_CYCLES,
            min(0xFFFFFFFF, round(total_cycles / segments)),
        )
        actual_s = segment_cycles * segments / self._clock_hz()
        return segment_cycles, segments, actual_s

    def _update_quantization(self):
        clocks = self._requested_dwell_cycles()
        dwell_ns = clocks * 1e9 / self._clock_hz()
        span_s = clocks * self.bins_spin.value() / self._clock_hz()
        self.quantized_label.setText(
            f"Actual: {dwell_ns:,.3f} ns · {clocks:,} clocks · "
            f"pass span {self._format_time(span_s)}"
        )

    @staticmethod
    def _format_time(seconds):
        if seconds < 1e-6:
            return f"{seconds * 1e9:,.3f} ns"
        if seconds < 1e-3:
            return f"{seconds * 1e6:,.3f} µs"
        if seconds < 1:
            return f"{seconds * 1e3:,.3f} ms"
        return f"{seconds:,.3f} s"

    @staticmethod
    def _format_duration(seconds):
        if seconds is None or not math.isfinite(seconds) or seconds < 0:
            return "—"
        if seconds < 60:
            return f"{seconds:,.1f} s"
        total_seconds = int(round(seconds))
        hours, remainder = divmod(total_seconds, 3600)
        minutes, secs = divmod(remainder, 60)
        if hours:
            return f"{hours:d}:{minutes:02d}:{secs:02d}"
        return f"{minutes:d}:{secs:02d}"

    def _begin_acquisition_timing(self, target_passes=None, baseline_passes=None):
        self.acquisition_started_at = time.monotonic()
        self.eta_pass_samples.clear()
        self.eta_last_rate = None
        self.eta_interval_values.clear()
        self.eta_interval_rates.clear()
        self.eta_display_eta = None
        self.eta_display_rate = None
        self.eta_last_display_update = time.monotonic()
        # Start a new acquisition interval without clearing MCS CPS history.
        # Clear CPS is the only action that erases that history. Rebase the
        # cumulative FPGA counters so a restart cannot create a false CPS spike.
        self.mcs_rate_last_time = None
        self.mcs_rate_last_total = None
        self.mcs_rate_last_passes = None
        self.mcs_rate_fit_samples.clear()
        self.mcs_rate_fit_signature = None
        # Do not let Stop/Pause wall time or stale cumulative coordinates create
        # a false CPS point.  The first frame after Start only establishes a new baseline.
        self.mcs_rate_baseline_pending = True
        self.mcs_display_frozen = False
        self.mcs_clear_pending = False
        self.acquisition_stopped_at = None
        self.acquisition_baseline_passes = int(
            self.accumulation_frames if baseline_passes is None else baseline_passes
        )
        self.acquisition_target_passes = (
            None if target_passes is None else int(target_passes)
        )
        self._update_acquisition_timing()

    def _finish_acquisition_timing(self):
        if self.acquisition_started_at is not None and self.acquisition_stopped_at is None:
            self.acquisition_stopped_at = time.monotonic()
        self._update_acquisition_timing()

    def _current_measured_eta_rate(self):
        """Return the current rolling FPGA pass-rate estimate without changing display state."""
        if len(self.eta_pass_samples) < 3:
            return None
        ts = np.asarray([q[0] for q in self.eta_pass_samples], dtype=np.float64)
        ps = np.asarray([q[1] for q in self.eta_pass_samples], dtype=np.float64)
        span = float(ts[-1] - ts[0])
        if span < self.eta_min_span_seconds or np.ptp(ps) <= 0.0:
            return None
        tc = ts - ts.mean(); pc = ps - ps.mean()
        denom = float(np.dot(tc, tc))
        if denom <= 0.0 or not math.isfinite(denom):
            return None
        rate = float(np.dot(tc, pc) / denom)
        return rate if math.isfinite(rate) and rate > 0.0 else None

    def _update_acquisition_timing(self):
        self._apply_layout_custom_texts()
        if self.acquisition_started_at is None:
            self.acquisition_elapsed.setText("—")
            self.acquisition_pass_rate.setText("—")
            self.acquisition_count_rate.setText("—")
            self.acquisition_time_left.setText("—")
            self.acquisition_finish_time.setText("—")
            self.status_timing.setText("Acquisition — · ETA —")
            return

        end_time = self.acquisition_stopped_at or time.monotonic()
        elapsed = max(0.0, end_time - self.acquisition_started_at)
        if self.instrument_mode == "counter" and self.latest_metadata is not None:
            current_passes = int(self.latest_metadata.get("pass_count", 0))
        else:
            current_passes = int(self.accumulation_frames)
        completed = max(0, current_passes - self.acquisition_baseline_passes)

        # ETA display is a 5-second arithmetic mean of ETA estimates collected
        # from valid FPGA pass progression. Data acquisition itself is unaffected.
        now_display = time.monotonic()
        measured_rate = self._current_measured_eta_rate()
        if measured_rate is not None:
            self.eta_last_rate = measured_rate
            self.eta_interval_rates.append(measured_rate)
            if self.acquisition_target_passes is not None:
                rem = max(0, self.acquisition_target_passes - current_passes)
                self.eta_interval_values.append(rem / measured_rate)

        if now_display - self.eta_last_display_update >= self.eta_display_period_s:
            if self.eta_interval_rates:
                self.eta_display_rate = float(np.mean(self.eta_interval_rates))
            if self.eta_interval_values:
                self.eta_display_eta = float(np.mean(self.eta_interval_values))
            self.eta_interval_rates.clear()
            self.eta_interval_values.clear()
            self.eta_last_display_update = now_display

        rate = self.eta_display_rate or 0.0
        elapsed_text = self._format_duration(elapsed)
        self.acquisition_elapsed.setText(elapsed_text)
        self.acquisition_pass_rate.setText(
            self._format_rate(rate, "pass/s") if rate > 0 else "Waiting for data"
        )
        count_rate = self.mcs_count_rates[-1] if self.mcs_count_rates else 0.0
        self.acquisition_count_rate.setText(
            self._format_rate(count_rate, "cps") if count_rate >= 0 and self.mcs_count_rates
            else "Waiting for data"
        )

        if self.acquisition_target_passes is None:
            remaining_text = "Continuous"
            finish_text = "Continuous"
        else:
            remaining_passes = max(0, self.acquisition_target_passes - current_passes)
            if remaining_passes == 0:
                remaining_text = "Complete"
                finish_text = time.strftime("%H:%M:%S")
            elif rate > 0:
                remaining_seconds = (self.eta_display_eta if self.eta_display_eta is not None else remaining_passes / rate)
                remaining_text = self._format_duration(remaining_seconds)
                finish_text = time.strftime(
                    "%H:%M:%S", time.localtime(time.time() + remaining_seconds)
                )
            else:
                remaining_text = "Measuring…"
                finish_text = "Measuring…"
        self.acquisition_time_left.setText(remaining_text)
        self.acquisition_finish_time.setText(finish_text)
        self.status_timing.setText(
            f"Acquisition {elapsed_text} · ETA {remaining_text}"
        )

    @staticmethod
    def _format_rate(value, unit):
        value = float(value)
        magnitude = abs(value)
        if magnitude >= 1e9:
            return f"{value / 1e9:,.3f} G{unit}"
        if magnitude >= 1e6:
            return f"{value / 1e6:,.3f} M{unit}"
        if magnitude >= 1e3:
            return f"{value / 1e3:,.3f} k{unit}"
        return f"{value:,.3f} {unit}"

    def _clear_mcs_rate_history(self):
        """Clear only the MCS CPS history; histogram and acquisition are untouched."""
        self.mcs_rate_times.clear()
        self.mcs_count_rates.clear()
        self.mcs_pass_rates.clear()
        self.mcs_rate_last_time = None
        self.mcs_rate_last_total = None
        self.mcs_rate_last_passes = None
        self.mcs_rate_started = None
        self.mcs_rate_fit_samples.clear()
        self.mcs_rate_fit_signature = None
        self.rate_curve.setData([], [])
        self.acquisition_count_rate.setText("Waiting for data")
        self._show_status("MCS CPS history cleared; histogram preserved", "success")

    def _set_rate_plot_enabled(self, enabled):
        self.rate_plot.setVisible(bool(enabled) and self.instrument_mode == "mcs")
        if enabled and self.mcs_rate_times:
            self.rate_curve.setData(
                list(self.mcs_rate_times), list(self.mcs_count_rates)
            )
            self.rate_plot.getViewBox().autoRange(padding=0.04)

    def _sync_counter_trigger_view(self):
        """Keep the independent Trigger Y view aligned with the main X view."""
        self.counter_trigger_view.setGeometry(
            self.plot.getViewBox().sceneBoundingRect()
        )
        self.counter_trigger_view.linkedViewChanged(
            self.plot.getViewBox(), self.counter_trigger_view.XAxis
        )

    def _update_counter_trace_visibility(self, _checked=None):
        """Apply independent Counter-channel visibility and axis controls."""
        counter = self.instrument_mode == "counter"
        show_signal = counter and self.counter_signal_check.isChecked()
        show_trigger = counter and self.counter_trigger_check.isChecked()
        self.curve.setVisible(not counter or show_signal)
        self.counter_trigger_curve.setVisible(show_trigger)
        self.counter_trigger_view.setVisible(show_trigger)
        self.plot.showAxis("right", show=show_trigger)
        if show_trigger:
            # Reapply the width after showAxis(); some pyqtgraph versions
            # restore the last auto-computed (collapsed) width when unhidden.
            self.counter_trigger_axis.setWidth(92)
            self._sync_counter_trigger_view()
            # Counter 2 owns an independent scale and should track its data;
            # the MCS histogram view remains fully manual during acquisition.
            self.counter_trigger_view.enableAutoRange(axis="y", enable=True)

    def _update_mcs_live_rates(self, metadata, counts, now):
        """Estimate CPS with one continuous free-intercept linear fit.

        The cumulative histogram total is fitted against completed FPGA passes
        as C(P)=m*P+b.  The free intercept absorbs the unknown partial-read
        offset in non-atomic live MCS6 previews.  The slope gives counts per
        complete pass; no startup/steady-state estimator switch is used.
        """
        total = int(counts.sum(dtype=np.uint64))
        passes = int(metadata.get("pass_count", self.accumulation_frames))
        bins = int(metadata.get("bin_count", counts.size))
        dwell_cycles = int(metadata.get("dwell_cycles", 0))
        clock_hz = self._clock_hz()
        pass_active_s = (
            bins * dwell_cycles / clock_hz
            if bins > 0 and dwell_cycles > 0 and clock_hz > 0.0
            else 0.0
        )

        # Preserve the atomic final histogram, but do not mix it into the live
        # regression.  The displayed CPS therefore holds its last valid value
        # instead of acquiring an artificial endpoint.
        if not self.acquisition_running or metadata.get("atomic_final"):
            self.mcs_rate_last_time = now
            self.mcs_rate_last_total = total
            self.mcs_rate_last_passes = passes
            return

        # On every Start/restart, consume exactly one valid live frame as a
        # baseline and do not append a CPS sample. Existing CPS history is preserved.
        if self.mcs_rate_baseline_pending:
            self.mcs_rate_fit_samples.clear()
            self.mcs_rate_fit_signature = (bins, dwell_cycles)
            self.mcs_rate_last_time = now
            self.mcs_rate_last_total = total
            self.mcs_rate_last_passes = passes
            self.mcs_rate_baseline_pending = False
            return

        signature = (bins, dwell_cycles)
        if signature != self.mcs_rate_fit_signature:
            self.mcs_rate_fit_samples.clear()
            self.mcs_rate_fit_signature = signature

        # Repeated, reversed, or reset cumulative coordinates cannot belong to
        # the current fit. Rebase without erasing the existing CPS history.
        if self.mcs_rate_fit_samples:
            old_passes, old_total = self.mcs_rate_fit_samples[-1]
            if passes <= old_passes or total < old_total:
                self.mcs_rate_fit_samples.clear()
        self.mcs_rate_fit_samples.append((passes, total))

        cps = linear_fit_active_rate(self.mcs_rate_fit_samples, pass_active_s)
        pps = None
        if (self.mcs_rate_last_time is not None and
                self.mcs_rate_last_passes is not None):
            wall_dt = now - self.mcs_rate_last_time
            dp = passes - self.mcs_rate_last_passes
            if dp > 0:
                pps = dp / wall_dt if wall_dt > 0.02 else 0.0

        if cps is not None:
            previous_pass = (
                self.mcs_rate_last_passes
                if self.mcs_rate_last_passes is not None else passes
            )
            active_dt = max(0, passes - previous_pass) * pass_active_s
            elapsed = (self.mcs_rate_times[-1] if self.mcs_rate_times else 0.0) + active_dt
            self.mcs_rate_times.append(elapsed)
            self.mcs_count_rates.append(cps)
            if pps is not None and pps > 0.0:
                self.mcs_pass_rates.append(pps)

            if self.plot_rate_check.isChecked():
                self.rate_curve.setData(
                    list(self.mcs_rate_times),
                    list(self.mcs_count_rates)
                )
                self.rate_plot.getViewBox().autoRange(padding=0.04)

        self.mcs_rate_last_time = now
        self.mcs_rate_last_total = total
        self.mcs_rate_last_passes = passes

    def _toggle_shortcuts_window(self, visible):
        """Show/hide a persistent always-on-top keyboard shortcut reference."""
        dialog = getattr(self, "_shortcuts_dialog", None)

        if visible and dialog is None:
            dialog = QDialog(self)
            dialog.setWindowTitle("OpenMCS — Keyboard shortcuts")
            dialog.setModal(False)
            dialog.setWindowFlag(Qt.WindowType.WindowStaysOnTopHint, True)
            dialog.setAttribute(Qt.WidgetAttribute.WA_DeleteOnClose, False)
            dialog.setMinimumWidth(500)

            layout = QVBoxLayout(dialog)
            layout.setContentsMargins(14, 14, 14, 14)
            title = QLabel("Keyboard shortcuts")
            title.setObjectName("SectionTitle")
            layout.addWidget(title)

            rows = (
                ("F5", "Start acquisition"),
                ("Shift+F5 / Esc", "Stop acquisition"),
                ("Ctrl+Enter", "Apply / prepare configuration"),
                ("Ctrl+L", "Clear accumulation / session"),
                ("Ctrl+S", "Export CSV"),
                ("Ctrl+Shift+S", "Export plot image"),
                ("Ctrl+Shift+D", "Save Data"),
                ("Ctrl+, / F2", "Open Setup"),
                ("Ctrl+1", "MCS mode"),
                ("Ctrl+2", "Counter mode"),
                ("Ctrl+3", "Toggle MCS self-test"),
                ("Ctrl+F", "Freeze current histogram as reference"),
                ("Ctrl+Shift+F", "Remove reference histogram"),
                ("Ctrl+R", "Toggle ROI"),
                ("Ctrl+D", "Toggle Difference plot"),
                ("Ctrl+Y", "Toggle Auto Y"),
                ("Ctrl+G", "Toggle Log Y"),
                ("Ctrl + left-click", "Select MCS bin / nearest Counter point"),
                ("Ctrl + left-drag", "Highlight a histogram range"),
                ("Arrow keys", "Move selected bin / Counter point by one"),
                ("Ctrl+Right", "Zoom X axis in around selected bin"),
                ("Ctrl+Left", "Zoom X axis out around selected bin"),
                ("Ctrl+Up", "Zoom Y axis in around selected bin"),
                ("Ctrl+Down", "Zoom Y axis out around selected bin"),
            )

            grid = QGridLayout()
            grid.setHorizontalSpacing(22)
            grid.setVerticalSpacing(7)
            for row, (keys, action) in enumerate(rows):
                key_label = QLabel(keys)
                key_label.setStyleSheet(
                    "font-family:'Consolas','Cascadia Mono',monospace; font-weight:700;"
                )
                action_label = QLabel(action)
                grid.addWidget(key_label, row, 0)
                grid.addWidget(action_label, row, 1)
            layout.addLayout(grid)

            close_button = QPushButton("Close")
            close_button.clicked.connect(
                lambda: self.shortcuts_button.setChecked(False)
            )
            close_row = QHBoxLayout()
            close_row.addStretch(1)
            close_row.addWidget(close_button)
            layout.addLayout(close_row)

            def shortcuts_close_event(event):
                event.ignore()
                self.shortcuts_button.setChecked(False)

            dialog.closeEvent = shortcuts_close_event
            self._shortcuts_dialog = dialog

        if dialog is None:
            return

        if visible:
            dialog.show()
            dialog.raise_()
            dialog.activateWindow()
        else:
            dialog.hide()

    def _show_acquisition_popup(self):
        """Open the acquisition controls as a persistent always-on-top dialog."""
        if getattr(self, "_acquisition_dialog", None) is None:
            dialog = QDialog(self)
            dialog.setWindowTitle("OpenMCS — Acquisition setup")
            dialog.setModal(False)
            # Parent-owned tool window: stays above the OpenMCS main window,
            # but does not use the global always-on-top hint.
            dialog.setWindowFlag(Qt.WindowType.Tool, True)
            dialog.setAttribute(Qt.WidgetAttribute.WA_DeleteOnClose, False)
            dialog.setMinimumWidth(430)
            dialog.setSizeGripEnabled(True)

            layout = QVBoxLayout(dialog)
            layout.setContentsMargins(10, 10, 10, 10)

            # Controls are hidden at application startup and become visible only
            # when they are placed into the Setup dialog.
            layout.addWidget(self.acquisition_group)
            self.acquisition_group.setVisible(True)

            close_row = QHBoxLayout()
            close_row.addStretch(1)
            close_button = QPushButton("Close")
            close_button.clicked.connect(dialog.hide)
            close_row.addWidget(close_button)
            layout.addLayout(close_row)

            # Clicking the title-bar X hides rather than destroys the dialog.
            def setup_close_event(event):
                event.ignore()
                dialog.hide()

            dialog.closeEvent = setup_close_event
            self._acquisition_dialog = dialog

        self._acquisition_dialog.show()
        self._acquisition_dialog.raise_()
        self._acquisition_dialog.activateWindow()

    def _apply_trigger_edge(self, _index=None):
        """Configure only the FPGA H2 edge detector; Teensy stimulus is unchanged."""
        edge = self.trigger_edge_combo.currentData() or "r"
        if self.worker is not None:
            self.send(f"q {'d' if edge == 'f' else 'u'}")

    def configure_acquisition(self):
        self._apply_trigger_edge()
        if self.instrument_mode == "counter":
            clocks, segments, actual_dwell = self._counter_timing()
            self.counter_segments_per_point = segments
            self.counter_segment_count = 0
            self.counter_segment_signal_sum = 0
            self.counter_segment_trigger_sum = 0
            self.counter_segment_elapsed = 0.0
            if self.send("p"):
                self.send(f"c 1 {clocks}")
                self.configured_signature = (1, clocks)
                self._request_counter_baseline()
                self._show_status(
                    f"Counter prepared: {actual_dwell:,.6f} s displayed dwell"
                    f" ({segments} FPGA segment{'s' if segments != 1 else ''}) · history preserved",
                    "success",
                )
            return
        if self.self_test_check.isChecked():
            clocks = self._requested_dwell_cycles()
            requested_signature = (self.bins_spin.value(), clocks)
            if self.configured_signature == requested_signature:
                self._show_status(
                    "Self-test is already prepared with these settings; histogram preserved. Press Start.",
                    "success",
                )
            elif self.send("p"):
                self.send(f"c {self.bins_spin.value()} {clocks}")
                self.configured_signature = requested_signature
                self._show_status(
                    f"Self-test prepared: target {self.test_passes_spin.value():,} total passes · {self.bins_spin.value():,} bins × {clocks:,} clocks "
                    f"= {clocks * 1e9 / self._clock_hz():,.3f} ns/bin. "
                    "Geometry changed; existing FPGA histogram is preserved. Press Start.",
                    "success",
                )
            return
        if not self._validate_mcs_timing():
            return
        clocks = self._requested_dwell_cycles()
        requested_signature = (self.bins_spin.value(), clocks)
        max_passes = 0 if self.unlimited_passes_check.isChecked() else self.max_passes_spin.value()

        # CFG5 updates acquisition geometry without clearing histogram RAM or
        # the accumulated pass counter. Explicit Clear is the only operation
        # that erases the FPGA accumulation.
        if self.configured_signature == requested_signature:
            self.send(f"m {max_passes}")
            self._show_status(
                f"Configuration unchanged: {self.bins_spin.value():,} bins, "
                f"{clocks:,} clocks ({clocks * 1e9 / self._clock_hz():,.3f} ns). "
                "Existing FPGA histogram preserved.",
                "success",
            )
        elif self.send("p"):
            self.send(f"m {max_passes}")
            self.send(f"c {self.bins_spin.value()} {clocks}")
            self.configured_signature = requested_signature
            self._show_status(
                f"Configuration changed: {self.bins_spin.value():,} bins, {clocks:,} clocks "
                f"({clocks * 1e9 / self._clock_hz():,.3f} ns). "
                "Existing FPGA histogram preserved; new passes will accumulate on top.",
                "success",
            )

    def start_run(self):
        if self.instrument_mode == "mcs" and self.self_test_check.isChecked():
            clocks = self._requested_dwell_cycles()
            requested_signature = (self.bins_spin.value(), clocks)
            max_passes = self.test_passes_spin.value()
            # The Teensy owns the conditional configuration decision. If this
            # geometry is already active, "y" starts another physical test
            # burst without clearing the FPGA histogram. A different geometry
            # must be configured and therefore starts a new accumulation.
            preserves_histogram = True
            baseline_passes = self.accumulation_frames
            # Program the absolute accumulated-pass target. The Teensy
            # self-test remains continuous while the FPGA is armed/active.
            self.send(f"m {max_passes}")
            if self.send(f"y {clocks} {self.bins_spin.value()}"):
                self.configured_signature = requested_signature
                self.acquisition_running = True
                self._begin_acquisition_timing(
                    None if max_passes == 0 else max_passes,
                    baseline_passes=baseline_passes,
                )
                limit_text = (
                    "continuous" if max_passes == 0
                    else f"target {max_passes:,} total passes"
                )
                self._show_status(
                    f"Self-test running: {limit_text} · "
                    f"histogram preserved · "
                    f"{self.bins_spin.value():,} bins × {clocks:,} clocks "
                    f"({clocks * 1e9 / self._clock_hz():,.3f} ns/bin); "
                    "expected bins 4, 49, 499, 3,999…",
                )
            return
        if self.instrument_mode == "counter":
            clocks, segments, actual_dwell = self._counter_timing()
            requested_signature = (1, clocks)
            self.counter_segments_per_point = segments
            self.counter_segment_count = 0
            self.counter_segment_signal_sum = 0
            self.counter_segment_trigger_sum = 0
            self.counter_segment_elapsed = 0.0

            # START MUST ONLY START.  A CFG5 transaction clears/reconfigures the
            # FPGA and is intentionally kept out of the normal Start path.
            # Configure once when the requested dwell has actually changed.
            # Counter/MCS transitions are serialized deliberately.  CFG5 is a
            # stop/config transaction in the FPGA; issuing K immediately behind it
            # can race the stop/clear/config CDC and leave Counter producing zeros.
            # Always STOP -> CONFIGURE -> short settle -> K when entering Counter.
            if self._counter_start_pending:
                return
            self._counter_start_pending = True
            if not self.send("p"):
                self._counter_start_pending = False
                return
            self.send(f"c 1 {clocks}")
            self.configured_signature = requested_signature
            self.acquisition_running = False
            self._show_status("Preparing simple counter and synchronizing FPGA mode…")

            def finish_counter_start():
                self._counter_start_pending = False
                if self.instrument_mode != "counter" or self.worker is None:
                    return
                self.acquisition_running = True
                self._begin_acquisition_timing(baseline_passes=0)
                self._request_counter_baseline()
                if self.send("k"):
                    self._show_status(
                        f"Dual-input counter running · {actual_dwell:,.6f} s dwell"
                        f" · {segments} FPGA segment{'s' if segments != 1 else ''}/point",
                        "success",
                    )
                else:
                    self.acquisition_running = False
                    self._finish_acquisition_timing()
            QTimer.singleShot(100, finish_counter_start)
            return
        if not self._validate_mcs_timing():
            return
        frequency = self.trigger_spin.value()
        requested_signature = (
            self.bins_spin.value(), self._requested_dwell_cycles()
        )
        max_passes = 0 if self.unlimited_passes_check.isChecked() else self.max_passes_spin.value()
        baseline_passes = int(self.accumulation_frames)

        def finish_mcs_internal_start():
            if self.instrument_mode != "mcs" or self.worker is None:
                return
            self.send(f"f {frequency}")
            self.send(f"m {max_passes}")
            if self.send("r"):
                self.acquisition_running = True
                self._begin_acquisition_timing(
                    None if max_passes == 0 else max_passes,
                    baseline_passes=baseline_passes
                )
                limit_text = "continuous" if max_passes == 0 else f"target {max_passes:,} total passes"
                self._show_status(
                    f"Internal trigger running at {frequency:,} Hz · {limit_text} · "
                    f"{self.bins_spin.value():,} bins × {self._requested_dwell_cycles():,} clocks",
                    "success"
                )
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
