sheekhoonatef15/OpenMCS/(commit log)

2026-10-08 Initial release of OpenMCS V1
    [500 ns_OpenMCS_100MHz_300MHz_test.csv]
2026-10-08 Update README with input sampler details and credits
    Clarified input sampler information and added credit for code generation.
2026-10-14 Bump version to 8.0.6 and enhance performance
    Updated application version and improved live preview functionality. Refactored histogram step calculation and frame handling for better performance.
